till-s/kicad-usbadc-s7m19507/hw/ft240x_fpga_test.kicad_pcb

## KiCad design hw/ft240x_fpga_test.kicad_pcb (2021-11-04)

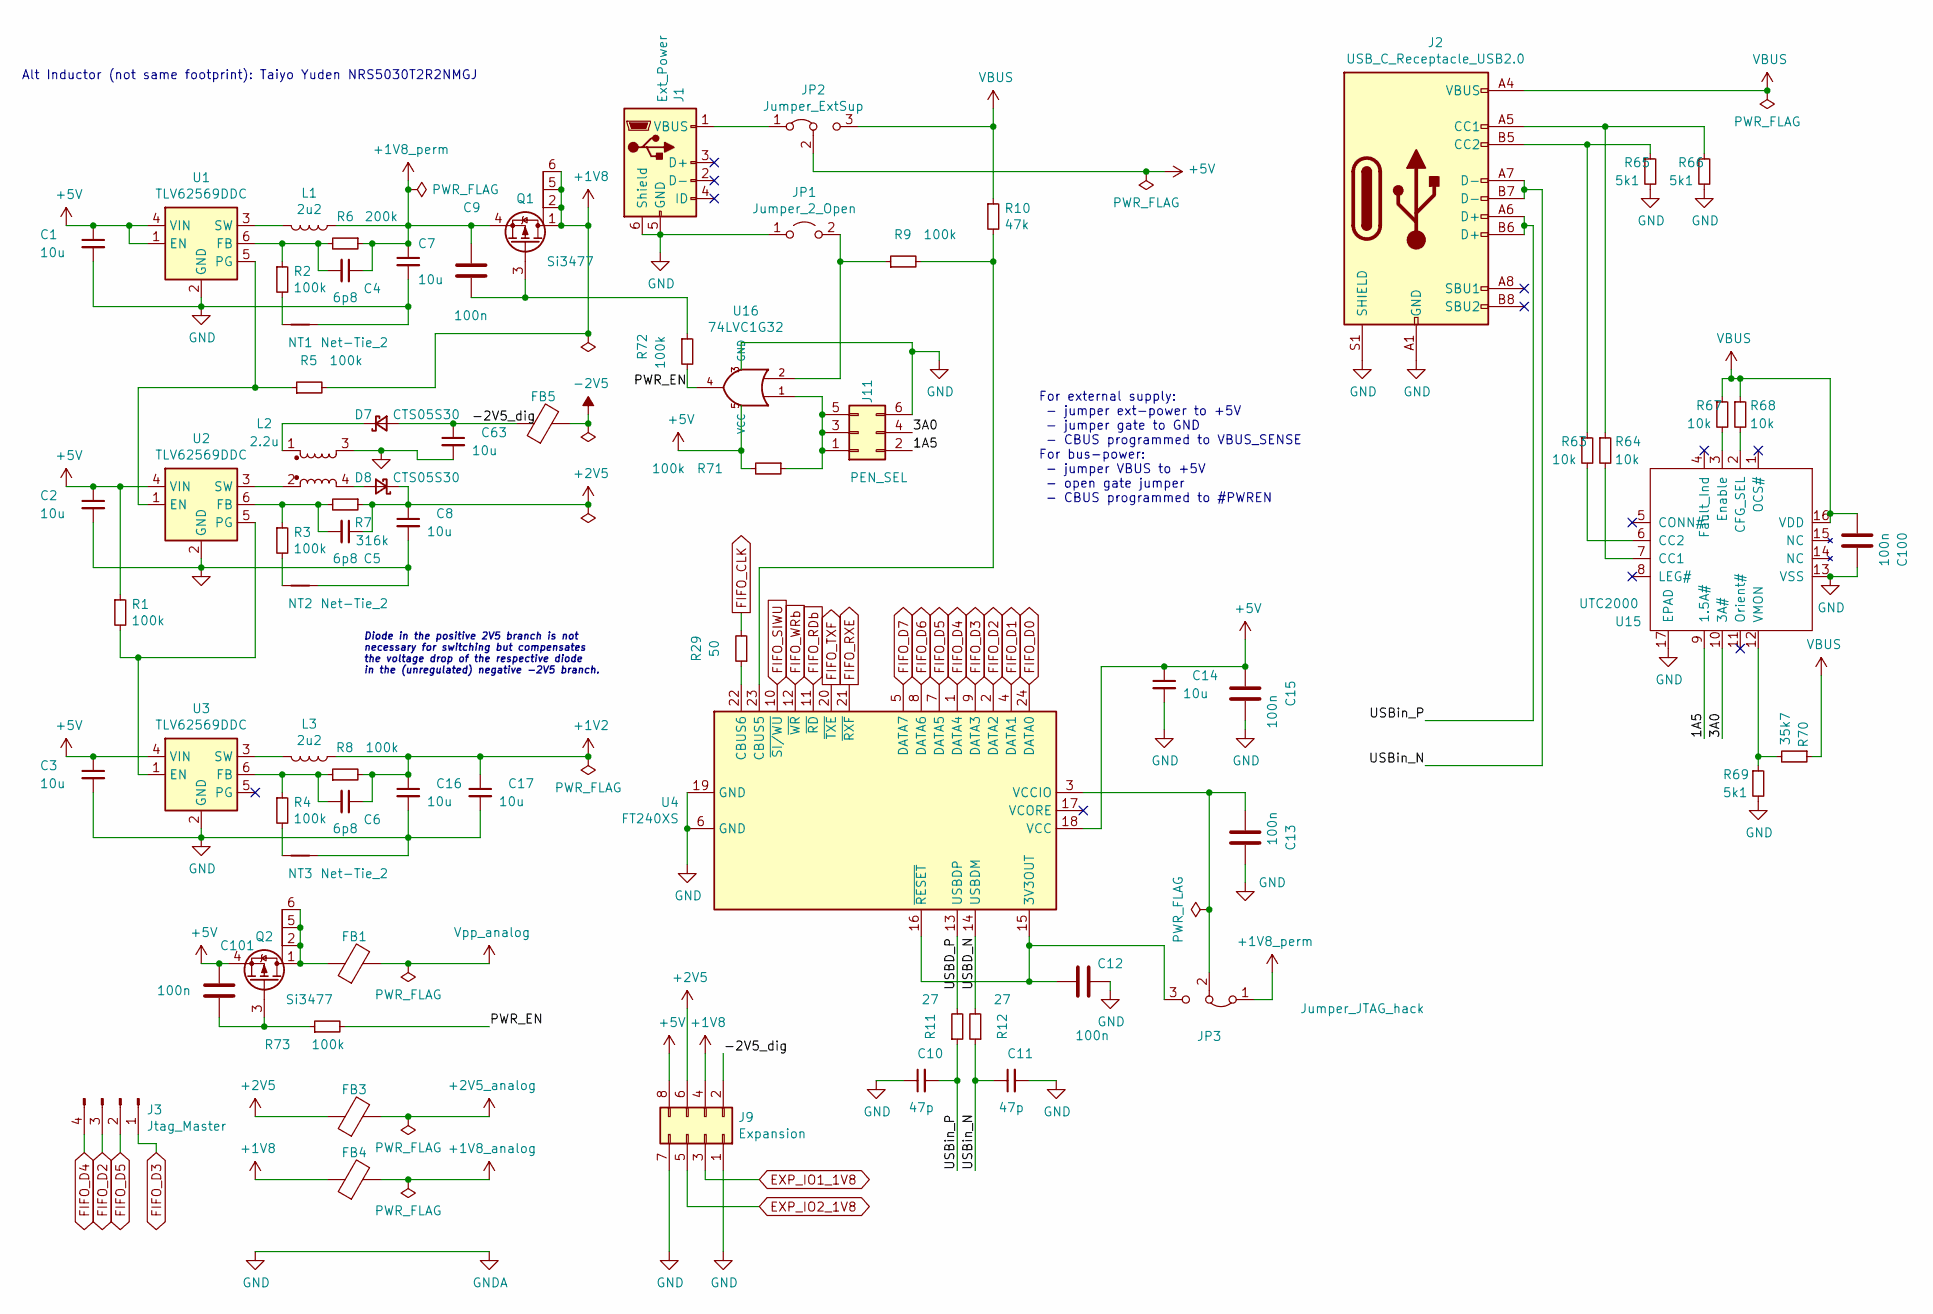
[picture p1: schematic power.sch]

Parts:
C1, C2, C3, C7, C8, C14, C16, C17, C63: 10u; C_1206_3216Metric; Part CNC5L1X7R1C106K160AE
C4, C5, C6: 6p8; C_0603_1608Metric; Part 885012006050
C9, C12, C13, C15, C100, C101: 100n; C_0603_1608Metric; Part GCJ188R71E104KA12D
C10, C11: 47p; C_0603_1608Metric; Part 885012006055
D7: CTS05S30; sod323; Part CTS05S30
D8: CTS05S30; sod323-special; Part CTS05S30
FB1, FB3, FB4, FB5: Ferrite_Bead MPZ1608S221A; L_0603_1608Metric; Part MPZ1608S221ATA00
J1: Ext_Power; USB_Micro-B_Molex-105017-0001; Part 1050170001
J2: USB_C_Receptacle_USB2.0; USB_C_Receptacle_GCT_USB4085_smaller_holes
J3: Jtag_Master; PinHeader_1x04_P2.54mm_Vertical
J9: Expansion; PinHeader_2x04_P2.54mm_Vertical
J11: PEN_SEL; PinHeader_2x03_P2.54mm_Vertical
JP1: Jumper_2_Open; PinHeader_1x02_P2.54mm_Vertical
JP2: Jumper_ExtSup; PinHeader_1x03_P2.54mm_Vertical
JP3: Jumper_JTAG_hack; PinHeader_1x03_P2.54mm_Vertical
L1, L3: 2u2; L_Taiyo-Yuden_NR-50xx; Part SRN8040TA-2R2Y
L2: 2.2u; L_Taiyo-Yuden_NR-50xx+bourns0703; Part SRF0703-2R2M
NT1, NT2, NT3: Net-Tie_2; NetTie-2_SMD_Pad0.5mm
Q1, Q2: Si3477; TSOT-23-6; Part Si3477
R1, R2, R3, R4, R5, R8, R9, R71, R72, R73: 100k; R_0603_1608Metric; Part RC0603FR-07100KL
R6: 200k; R_0603_1608Metric; Part ERJ-3EKF2003V
R7: 316k; R_0603_1608Metric; Part RC0603FR-07316KL
R10: 47k; R_0603_1608Metric; Part RC0603FR-07100KL
R11, R12: 27; R_0603_1608Metric; Part RC0603FR-0727RL
R29: 50; R_0402_1005Metric
R63, R64, R67, R68: 10k; R_0603_1608Metric
R65, R66, R69: 5k1; R_0603_1608Metric
R70: 35k7; R_0603_1608Metric
U1, U2, U3: TLV62569DDC; SOT-23-6; Part TLV62569PDDC
U4: FT240XS; SSOP-24_3.9x8.7mm_P0.635mm; Part FT240XS-U
U15: UTC2000; QFN-16-1EP_3x3mm_P0.5mm_EP1.75x1.75mm_ThermalVias; Part UTC2000
U16: 74LVC1G32; SOT-353_SC-70-5

Connections:
+1V2: C6.1, C16.1, C17.1, L3.1, R8.2; also elsewhere on the board
+1V8: FB4.1, J9.4, Q1.1 (D), Q1.2 (D), Q1.5 (D), Q1.6 (D), R5.2; also elsewhere on the board
+1V8_analog: FB4.2; also elsewhere on the board
+1V8_perm: C4.1, C7.1, C9.2, JP3.1 (A), L1.1, Q1.4 (S), R6.1
+2V5: C5.1, C8.1, D8.1 (K), FB3.1, J9.6, R7.1; also elsewhere on the board
+2V5_analog: FB3.2; also elsewhere on the board
+5V: C1.1, C2.1, C3.1, C14.1, C15.2, C101.2, J9.8, JP2.2 (C), Q2.4 (S), R1.1, R71.2, U1.1 (EN), U1.4 (VIN), U2.4 (VIN), U3.4 (VIN), U4.18 (VCC), U16.5 (VCC); also elsewhere on the board
-2V5: FB5.2; also elsewhere on the board
/Power/1A5: J11.2, U15.9 (1.5A#)
/Power/3A0: J11.4, U15.10 (3A#)
/Power/-2V5_dig: C63.1, D7.2 (A), FB5.1, J9.2
/Power/PWR_EN: R72.2, R73.2, U16.4
/Power/USBD_N: R12.2, U4.14 (USBDM)
/Power/USBD_P: R11.2, U4.13 (USBDP)
/Power/USBin_N: C11.1, J2.A7 (D-), J2.B7 (D-), R12.1
/Power/USBin_P: C10.2, J2.A6 (D+), J2.B6 (D+), R11.1
EXP_IO1_1V8: J9.3; also elsewhere on the board
EXP_IO2_1V8: J9.5; also elsewhere on the board
FIFO_CLK: R29.2; also elsewhere on the board
FIFO_D0: U4.24 (DATA0); also elsewhere on the board
FIFO_D1: U4.4 (DATA1); also elsewhere on the board
FIFO_D2: J3.3, U4.2 (DATA2); also elsewhere on the board
FIFO_D3: J3.1, U4.9 (DATA3); also elsewhere on the board
FIFO_D4: J3.4, U4.1 (DATA4); also elsewhere on the board
FIFO_D5: J3.2, U4.7 (DATA5); also elsewhere on the board
FIFO_D6: U4.8 (DATA6); also elsewhere on the board
FIFO_D7: U4.5 (DATA7); also elsewhere on the board
FIFO_RDb: U4.11 (~RD); also elsewhere on the board
FIFO_RXE: U4.21 (~RXF); also elsewhere on the board
FIFO_SIWU: U4.10 (~SI/WU); also elsewhere on the board
FIFO_TXF: U4.20 (~TXE); also elsewhere on the board
FIFO_WRb: U4.12 (~WR); also elsewhere on the board
unnamed: C4.2, R2.1, R6.2, U1.6 (FB)
unnamed: C5.2, R3.1, R7.2, U2.6 (FB)
unnamed: C6.2, R4.1, R8.1, U3.6 (FB)
unnamed: C9.1, Q1.3 (G), R72.1
unnamed: C12.2, JP3.3 (B), U4.15 (3V3OUT), U4.16 (~RESET)
unnamed: C13.2, JP3.2 (C), U4.3 (VCCIO)
unnamed: C101.1, Q2.3 (G), R73.1
unnamed: D7.1 (K), L2.1
unnamed: D8.2 (A), L2.4
unnamed: FB1.1, Q2.1 (D), Q2.2 (D), Q2.5 (D), Q2.6 (D)
unnamed: J1.1 (VBUS), JP2.1 (A)
unnamed: J2.A5 (CC1), R64.1, R66.1
unnamed: J2.B5 (CC2), R63.1, R65.1
unnamed: J11.1, J11.3, J11.5, R71.1, U16.1
unnamed: JP1.2 (B), R9.1, U16.2
unnamed: L1.2, U1.3 (SW)
unnamed: L2.2, U2.3 (SW)
unnamed: L3.2, U3.3 (SW)
unnamed: NT1.1, R2.2
unnamed: NT2.1, R3.2
unnamed: NT3.1, R4.2
unnamed: R1.2, U2.5 (PG), U3.1 (EN)
unnamed: R5.1, U1.5 (PG), U2.1 (EN)
unnamed: R9.2, R10.2, U4.23 (CBUS5)
unnamed: R29.1, U4.22 (CBUS6)
unnamed: R63.2, U15.6 (CC2)
unnamed: R64.2, U15.7 (CC1)
unnamed: R67.2, U15.3 (Enable)
unnamed: R68.2, U15.2 (CFG_SEL)
unnamed: R69.1, R70.2, U15.12 (VMON)
VBUS: C100.1, J2.A4 (VBUS), J2.A9 (VBUS), J2.B4 (VBUS), J2.B9 (VBUS), JP2.3 (B), R10.1, R67.1, R68.1, R70.1, U15.16 (VDD)
Vpp_analog: FB1.2; also elsewhere on the board

Notes on the sheet:
For external supply: - jumper ext-power to +5V - jumper gate to GND - CBUS programmed to VBUS_SENSE For bus-power: - jumper VBUS to +5V - open gate jumper - CBUS programmed to #PWREN
Alt Inductor (not same footprint): Taiyo Yuden NRS5030T2R2NMGJ
Diode in the positive 2V5 branch is not necessary for switching but compensates the voltage drop of the respective diode in the (unregulated) negative -2V5 branch.

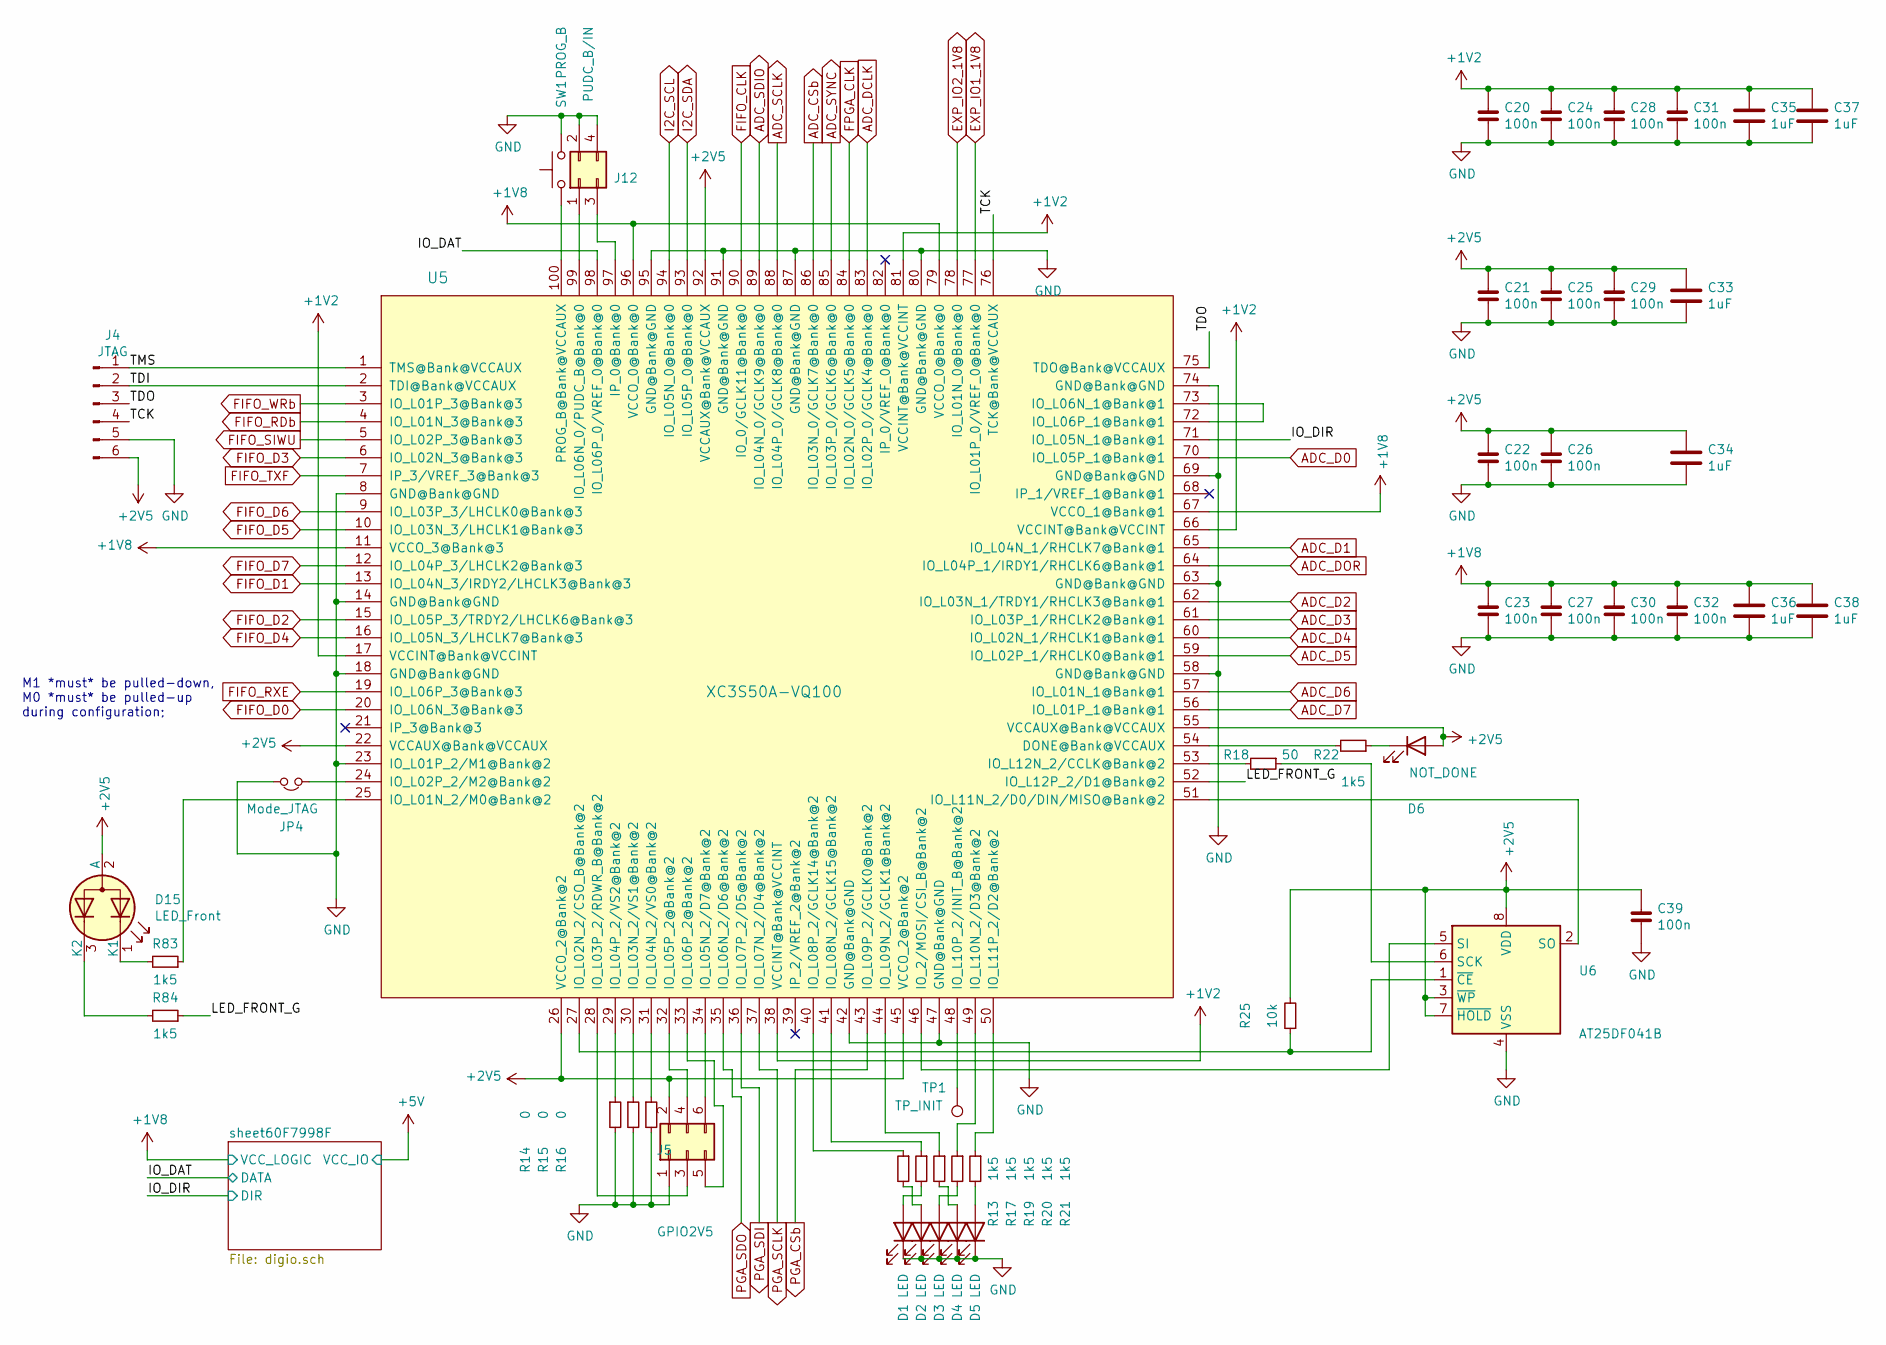
[picture p2: schematic fpga_xc3s.sch]

Parts:
C20, C21, C22, C23, C24, C25, C26, C27, C28, C29, C30, C31, C32, C39: 100n; C_0402_1005Metric; Part GRM155R61C104KA88D
C33, C34, C35, C36, C37, C38: 1uF; C_0805_2012Metric; Part GCJ219R71C105KA01
D1, D2, D3, D4, D5, D6: LED; LED_0603_1608Metric; Part 150060RS75000
D15: LED_Front; LED_Wuerth_Sideview
J4: JTAG; PinHeader_1x06_P2.54mm_Vertical
J5: GPIO2V5; PinHeader_2x03_P2.54mm_Vertical
J12: PUDC_B/IN; PinHeader_2x02_P2.54mm_Vertical
JP4: Mode_JTAG; PinHeader_1x02_P2.54mm_Vertical
R13, R17, R19, R20, R21, R22, R83, R84: 1k5; R_0603_1608Metric; Part RC0603FR-071K5L
R14, R15, R16: 0; R_0603_1608Metric; Part RMCF0603ZT0R00
R18: 50; R_0603_1608Metric
R25: 10k; R_0603_1608Metric; Part RT0603FRE0710KL
SW1: PROG_B; SW_SPST_PTS810
TP1: TP_INIT; TestPoint_Pad_D1.0mm
U5: XC3S50A-VQ100; VQFP-100_14x14mm_P0.5mm
U6: AT25DF041B; SOIC-8_3.9x4.9mm_P1.27mm; Part AT25DF041B

Connections:
+1V2: C20.1, C24.1, C28.1, C31.1, C35.1, C37.1, U5.17 (VCCINT@Bank@VCCINT), U5.38 (VCCINT@Bank@VCCINT), U5.66 (VCCINT@Bank@VCCINT), U5.81 (VCCINT@Bank@VCCINT); also elsewhere on the board
+1V8: C23.1, C27.1, C30.1, C32.1, C36.1, C38.1, U5.11 (VCCO_3@Bank@3), U5.67 (VCCO_1@Bank@1), U5.79 (VCCO_0@Bank@0), U5.96 (VCCO_0@Bank@0); also elsewhere on the board
+2V5: C21.1, C22.1, C25.1, C26.1, C29.1, C33.1, C34.1, C39.1, D6.2 (A), D15.2 (A), J4.6, J5.2, R25.2, U5.22 (VCCAUX@Bank@VCCAUX), U5.26 (VCCO_2@Bank@2), U5.45 (VCCO_2@Bank@2), U5.55 (VCCAUX@Bank@VCCAUX), U5.92 (VCCAUX@Bank@VCCAUX), U6.3 (~WP~), U6.7 (~HOLD~), U6.8 (VDD); also elsewhere on the board
/fpga_xc3s/IO_DAT: U5.98 (IO_L06P_0/VREF_0@Bank@0); also elsewhere on the board
/fpga_xc3s/IO_DIR: U5.71 (IO_L05N_1@Bank@1); also elsewhere on the board
/fpga_xc3s/LED_FRONT_G: R84.1, U5.52 (IO_L12P_2/D1@Bank@2)
/fpga_xc3s/TCK: J4.4, U5.76 (TCK@Bank@VCCAUX)
/fpga_xc3s/TDI: J4.2, U5.2 (TDI@Bank@VCCAUX)
/fpga_xc3s/TDO: J4.3, U5.75 (TDO@Bank@VCCAUX)
/fpga_xc3s/TMS: J4.1, U5.1 (TMS@Bank@VCCAUX)
ADC_CSb: U5.86 (IO_L03N_0/GCLK7@Bank@0); also elsewhere on the board
ADC_D0: U5.70 (IO_L05P_1@Bank@1); also elsewhere on the board
ADC_D1: U5.65 (IO_L04N_1/RHCLK7@Bank@1); also elsewhere on the board
ADC_D2: U5.62 (IO_L03N_1/TRDY1/RHCLK3@Bank@1); also elsewhere on the board
ADC_D3: U5.61 (IO_L03P_1/RHCLK2@Bank@1); also elsewhere on the board
ADC_D4: U5.60 (IO_L02N_1/RHCLK1@Bank@1); also elsewhere on the board
ADC_D5: U5.59 (IO_L02P_1/RHCLK0@Bank@1); also elsewhere on the board
ADC_D6: U5.57 (IO_L01N_1@Bank@1); also elsewhere on the board
ADC_D7: U5.56 (IO_L01P_1@Bank@1); also elsewhere on the board
ADC_DCLK: U5.83 (IO_L02P_0/GCLK4@Bank@0); also elsewhere on the board
ADC_DOR: U5.64 (IO_L04P_1/IRDY1/RHCLK6@Bank@1); also elsewhere on the board
ADC_SCLK: U5.88 (IO_L04P_0/GCLK8@Bank@0); also elsewhere on the board
ADC_SDIO: U5.89 (IO_L04N_0/GCLK9@Bank@0); also elsewhere on the board
ADC_SYNC: U5.85 (IO_L03P_0/GCLK6@Bank@0); also elsewhere on the board
EXP_IO1_1V8: U5.77 (IO_L01P_0/VREF_0@Bank@0); also elsewhere on the board
EXP_IO2_1V8: U5.78 (IO_L01N_0@Bank@0); also elsewhere on the board
FIFO_CLK: U5.90 (IO_0/GCLK11@Bank@0); also elsewhere on the board
FIFO_D0: U5.20 (IO_L06N_3@Bank@3); also elsewhere on the board
FIFO_D1: U5.13 (IO_L04N_3/IRDY2/LHCLK3@Bank@3); also elsewhere on the board
FIFO_D2: U5.15 (IO_L05P_3/TRDY2/LHCLK6@Bank@3); also elsewhere on the board
FIFO_D3: U5.6 (IO_L02N_3@Bank@3); also elsewhere on the board
FIFO_D4: U5.16 (IO_L05N_3/LHCLK7@Bank@3); also elsewhere on the board
FIFO_D5: U5.10 (IO_L03N_3/LHCLK1@Bank@3); also elsewhere on the board
FIFO_D6: U5.9 (IO_L03P_3/LHCLK0@Bank@3); also elsewhere on the board
FIFO_D7: U5.12 (IO_L04P_3/LHCLK2@Bank@3); also elsewhere on the board
FIFO_RDb: U5.4 (IO_L01N_3@Bank@3); also elsewhere on the board
FIFO_RXE: U5.19 (IO_L06P_3@Bank@3); also elsewhere on the board
FIFO_SIWU: U5.5 (IO_L02P_3@Bank@3); also elsewhere on the board
FIFO_TXF: U5.7 (IP_3/VREF_3@Bank@3); also elsewhere on the board
FIFO_WRb: U5.3 (IO_L01P_3@Bank@3); also elsewhere on the board
FPGA_CLK: U5.84 (IO_L02N_0/GCLK5@Bank@0); also elsewhere on the board
I2C_SCL: U5.94 (IO_L05N_0@Bank@0); also elsewhere on the board
I2C_SDA: U5.93 (IO_L05P_0@Bank@0); also elsewhere on the board
unnamed: D1.2 (A), R17.2
unnamed: D2.2 (A), R13.2
unnamed: D3.2 (A), R20.2
unnamed: D4.2 (A), R19.2
unnamed: D5.2 (A), R21.2
unnamed: D6.1 (K), R22.1
unnamed: D15.1 (K1), R83.2
unnamed: D15.3 (K2), R84.2
unnamed: J5.3, U5.28 (IO_L03P_2/RDWR_B@Bank@2)
unnamed: J5.4, U5.32 (IO_L05P_2@Bank@2)
unnamed: J5.5, U5.33 (IO_L06P_2@Bank@2)
unnamed: J5.6, U5.34 (IO_L05N_2/D7@Bank@2)
unnamed: J12.1, U5.99 (IO_L06N_0/PUDC_B@Bank@0)
unnamed: J12.3, U5.97 (IP_0@Bank@0)
unnamed: JP4.1, U5.24 (IO_L02P_2/M2@Bank@2)
unnamed: R13.1, U5.40 (IO_L08P_2/GCLK14@Bank@2)
unnamed: R14.1, U5.29 (IO_L04P_2/VS2@Bank@2)
unnamed: R15.1, U5.30 (IO_L03N_2/VS1@Bank@2)
unnamed: R16.1, U5.31 (IO_L04N_2/VS0@Bank@2)
unnamed: R17.1, U5.41 (IO_L08N_2/GCLK15@Bank@2)
unnamed: R18.1, U6.6 (SCK)
unnamed: R18.2, U5.53 (IO_L12N_2/CCLK@Bank@2)
unnamed: R19.1, U5.44 (IO_L09N_2/GCLK1@Bank@2)
unnamed: R20.1, U5.49 (IO_L10N_2/D3@Bank@2)
unnamed: R21.1, U5.50 (IO_L11P_2/D2@Bank@2)
unnamed: R22.2, U5.54 (DONE@Bank@VCCAUX)
unnamed: R25.1, U5.27 (IO_L02N_2/CSO_B@Bank@2), U6.1 (~CE)
unnamed: R83.1, U5.25 (IO_L01N_2/M0@Bank@2)
unnamed: SW1.1, U5.100 (PROG_B@Bank@VCCAUX)
unnamed: TP1.1, U5.48 (IO_L10P_2/INIT_B@Bank@2)
unnamed: U5.46 (IO_2/MOSI/CSI_B@Bank@2), U6.5 (SI)
unnamed: U5.51 (IO_L11N_2/D0/DIN/MISO@Bank@2), U6.2 (SO)
unnamed: U5.72 (IO_L06P_1@Bank@1), U5.73 (IO_L06N_1@Bank@1)
PGA_CSb: U5.43 (IO_L09P_2/GCLK0@Bank@2); also elsewhere on the board
PGA_SCLK: U5.37 (IO_L07N_2/D4@Bank@2); also elsewhere on the board
PGA_SDI: U5.36 (IO_L07P_2/D5@Bank@2); also elsewhere on the board
PGA_SDO: U5.35 (IO_L06N_2/D6@Bank@2); also elsewhere on the board

Notes on the sheet:
M1 *must* be pulled-down, M0 *must* be pulled-up during configuration;

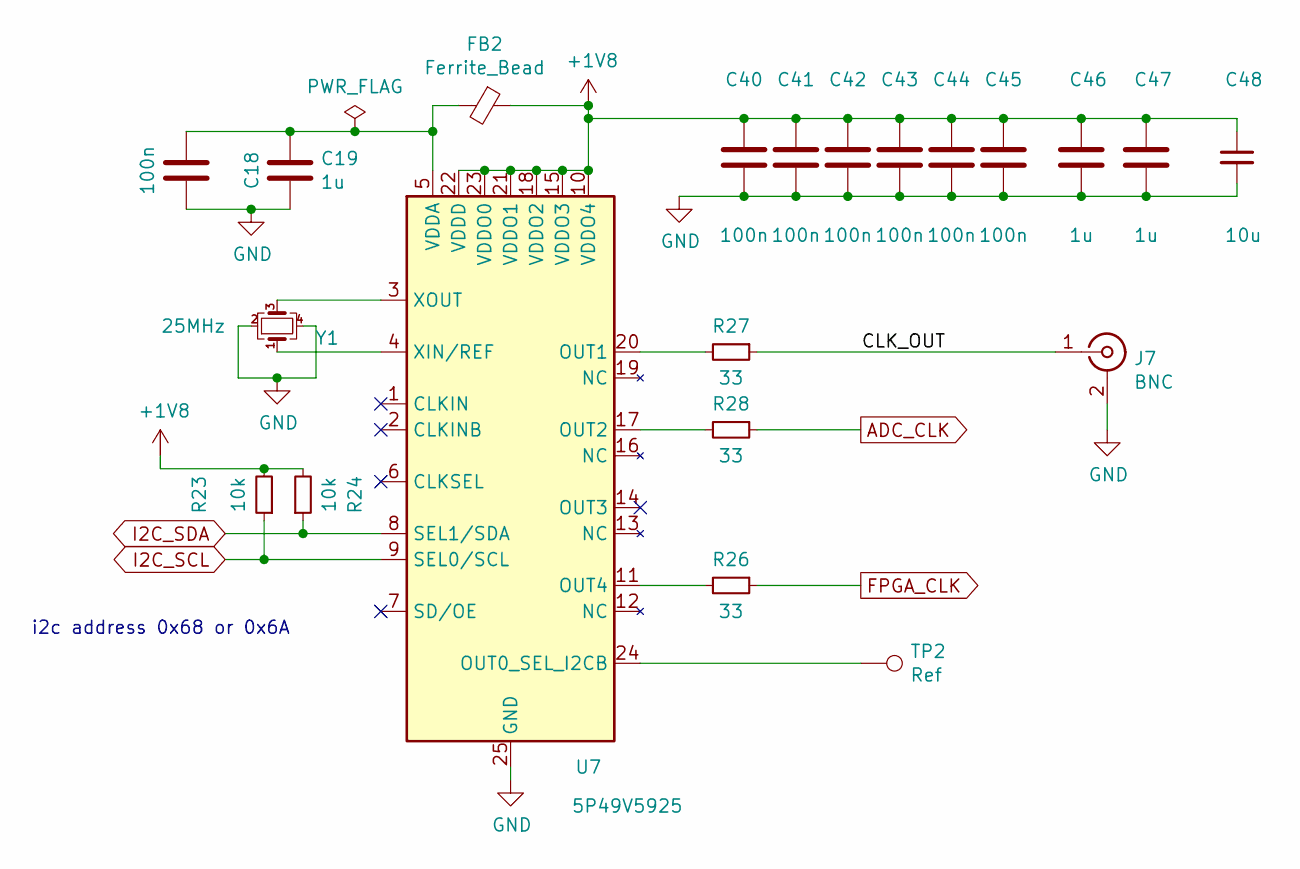
[picture p3: schematic pll_clock.sch]

Parts:
C18, C40, C41, C42, C43, C44, C45: 100n; C_0603_1608Metric; Part GCJ188R71E104KA12D
C19, C46, C47: 1u; C_0805_2012Metric; Part GCJ219R71C105KA01
C48: 10u; C_1206_3216Metric; Part CNC5L1X7R1C106K160AE
FB2: Ferrite_Bead; L_0603_1608Metric; Part MPZ1608S221ATA00
J7: BNC; BNC_Molex_0731713150; Part 0731713150
R23, R24: 10k; R_0603_1608Metric; Part RT0603FRE0710KL
R26, R27, R28: 33; R_0603_1608Metric; Part RC0603FR-0733RL
TP2: Ref; TestPoint_Pad_D0.8mm_no_CY
U7: 5P49V5925; QFN-24-1EP_4x4mm_P0.5mm_EP2.8x2.8mm; Part 5P49V5925
Y1: 25MHz; Crystal_SMD_Abracon_ABM10-4Pin_2.5x2.0mm; Part ABM10W-25.0000MHZ-8-B1U-T3

Connections:
+1V8: C40.2, C41.2, C42.2, C43.2, C44.2, C45.2, C46.1, C47.1, C48.1, FB2.1, R23.2, R24.2, U7.10 (VDDO4), U7.15 (VDDO3), U7.18 (VDDO2), U7.21 (VDDO1), U7.22 (VDDD), U7.23 (VDDO0); also elsewhere on the board
/pll_clock/CLK_OUT: J7.1 (In), R27.1
ADC_CLK: R28.1; also elsewhere on the board
FPGA_CLK: R26.1; also elsewhere on the board
I2C_SCL: R23.1, U7.9 (SEL0/SCL); also elsewhere on the board
I2C_SDA: R24.1, U7.8 (SEL1/SDA); also elsewhere on the board
unnamed: C18.2, C19.1, FB2.2, U7.5 (VDDA)
unnamed: R26.2, U7.11 (OUT4)
unnamed: R27.2, U7.20 (OUT1)
unnamed: R28.2, U7.17 (OUT2)
unnamed: TP2.1, U7.24 (OUT0_SEL_I2CB)
unnamed: U7.3 (XOUT), Y1.3
unnamed: U7.4 (XIN/REF), Y1.1

Notes on the sheet:
i2c address 0x68 or 0x6A

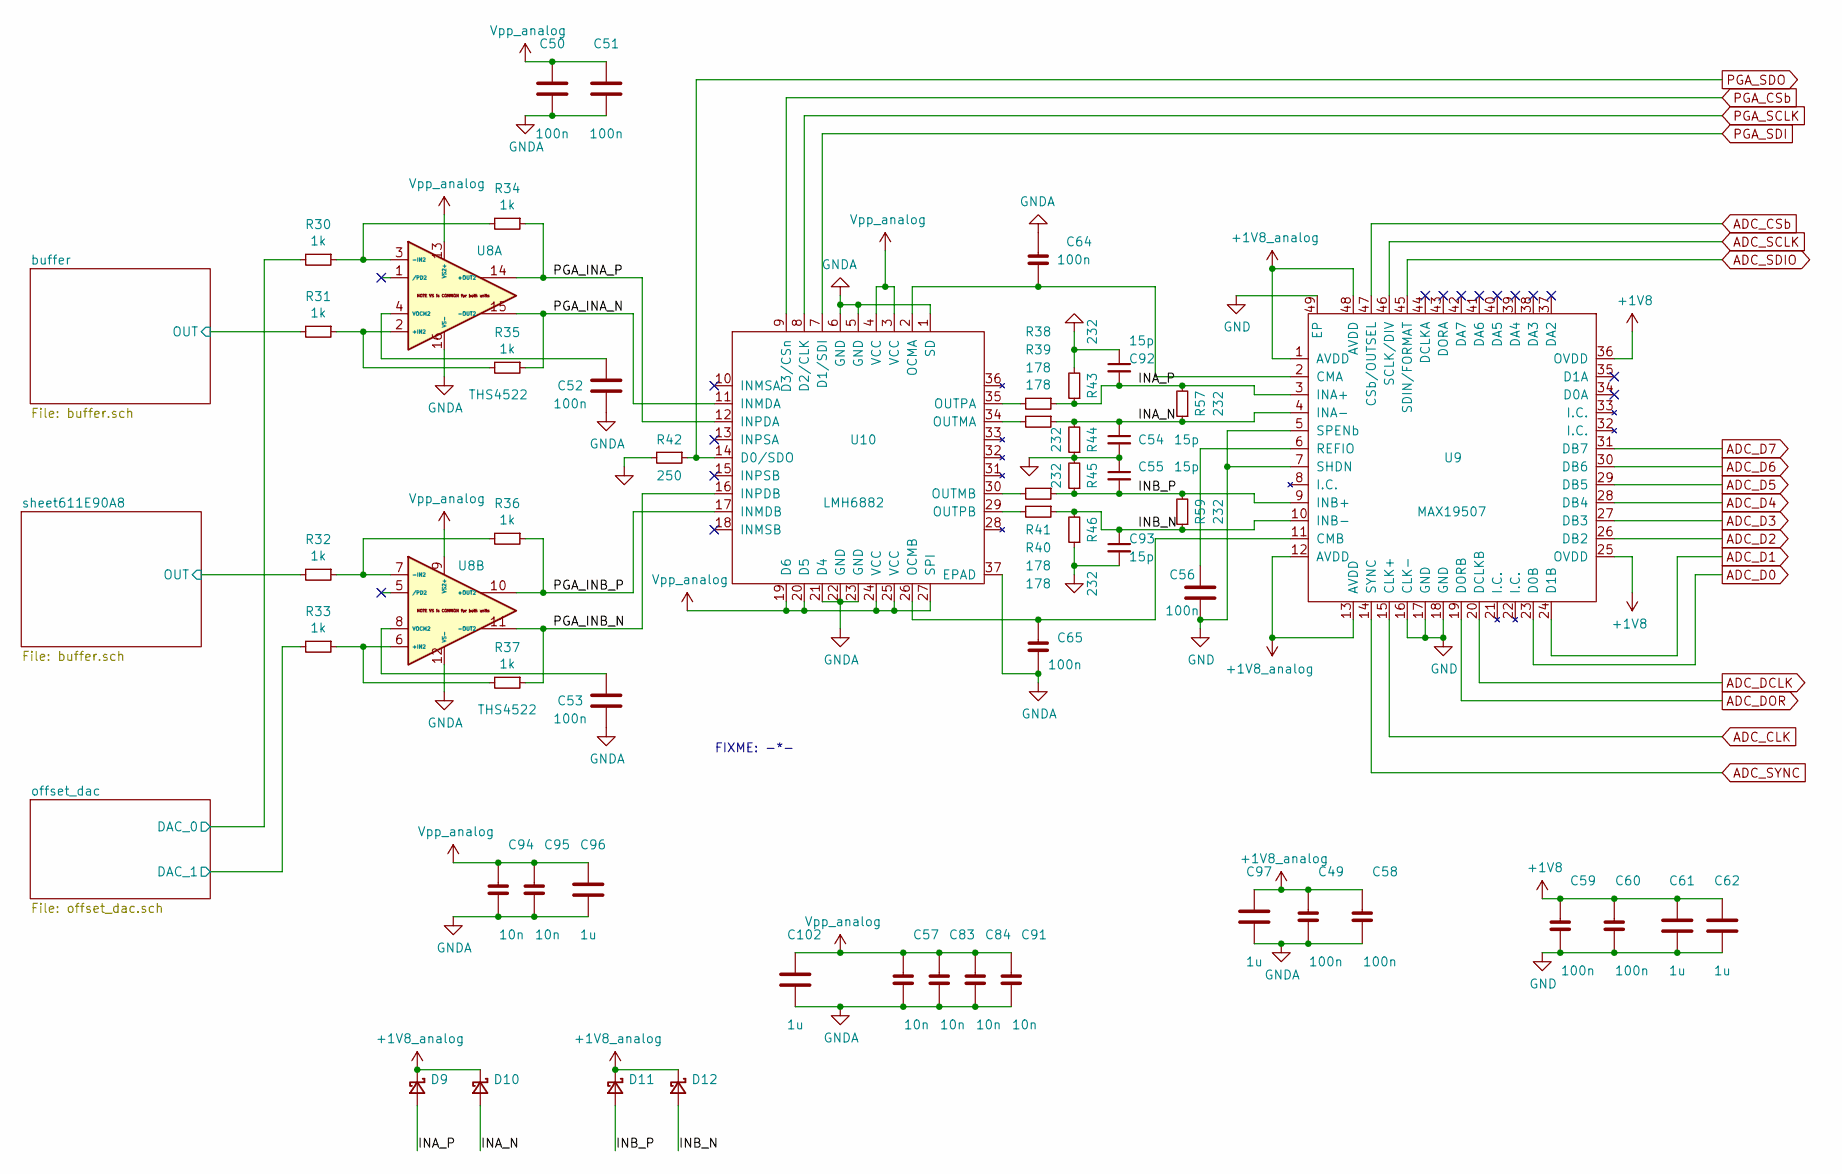
[picture p4: schematic max19507.sch]

Parts:
C49, C58, C59, C60, C64, C65: 100n; C_0402_1005Metric; Part GRM155R61C104KA88D
C50, C51, C52, C53, C56: 100n; C_0603_1608Metric; Part GCJ188R71E104KA12D
C54, C55, C92, C93: 15p; C_0603_1608Metric
C57, C83, C84, C91, C94, C95: 10n; C_0402_1005Metric; Part GRM155R61C103KA01
C61, C62, C96, C97, C102: 1u; C_0805_2012Metric; Part GCJ219R71C105KA01
D9, D10, D11, D12: NSR0170HT1G; D_SOD-323; Part NSR0170HT1G
R30, R31, R32, R33, R34, R35, R36, R37: 1k; R_0603_1608Metric
R38, R39, R40, R41: 178; R_0603_1608Metric
R42: 250; R_0603_1608Metric
R43, R44, R45, R46, R57, R59: 232; R_0603_1608Metric
U8: THS4522; TSSOP-16_4.4x5mm_P0.65mm
U9: MAX19507; TQFP-48-1EP_7x7mm_P0.5mm_EP5x5mm_ThermalVias
U10: LMH6882; Texas_S-PVQFN-N36_EP4.4x4.4mm_ThermalVias; Part LMH6882

Connections:
+1V8: C59.1, C60.1, C61.1, C62.1, U9.25 (OVDD), U9.36 (OVDD); also elsewhere on the board
+1V8_analog: C49.1, C58.1, C97.1, D9.1 (K), D10.1 (K), D11.1 (K), D12.1 (K), U9.1 (AVDD), U9.12 (AVDD), U9.13 (AVDD), U9.48 (AVDD); also elsewhere on the board
/ADC+Driver/INA_N: C54.1, D10.2 (A), R39.1, R44.2, R57.1, U9.4 (INA-)
/ADC+Driver/INA_P: C92.2, D9.2 (A), R38.1, R43.1, R57.2, U9.3 (INA+)
/ADC+Driver/INB_N: C93.1, D12.2 (A), R41.1, R46.2, R59.1, U9.10 (INB-)
/ADC+Driver/INB_P: C55.2, D11.2 (A), R40.1, R45.1, R59.2, U9.9 (INB+)
/ADC+Driver/PGA_INA_N: R35.1, U8.15 (-OUT2), U10.11 (INMDA)
/ADC+Driver/PGA_INA_P: R34.1, U8.14 (+OUT2), U10.12 (INPDA)
/ADC+Driver/PGA_INB_N: R37.1, U8.11 (-OUT2), U10.16 (INPDB)
/ADC+Driver/PGA_INB_P: R36.1, U8.10 (+OUT2), U10.17 (INMDB)
/ADC+Driver/buffer/OUT: R31.2; also elsewhere on the board
/ADC+Driver/offset_dac/DAC_0: R30.2; also elsewhere on the board
/ADC+Driver/offset_dac/DAC_1: R33.2; also elsewhere on the board
/ADC+Driver/sheet611E90A8/OUT: R32.2; also elsewhere on the board
ADC_CLK: U9.15 (CLK+); also elsewhere on the board
ADC_CSb: U9.47 (CSb/OUTSEL); also elsewhere on the board
ADC_D0: U9.23 (D0B); also elsewhere on the board
ADC_D1: U9.24 (D1B); also elsewhere on the board
ADC_D2: U9.26 (DB2); also elsewhere on the board
ADC_D3: U9.27 (DB3); also elsewhere on the board
ADC_D4: U9.28 (DB4); also elsewhere on the board
ADC_D5: U9.29 (DB5); also elsewhere on the board
ADC_D6: U9.30 (DB6); also elsewhere on the board
ADC_D7: U9.31 (DB7); also elsewhere on the board
ADC_DCLK: U9.20 (DCLKB); also elsewhere on the board
ADC_DOR: U9.19 (DORB); also elsewhere on the board
ADC_SCLK: U9.46 (SCLK/DIV); also elsewhere on the board
ADC_SDIO: U9.45 (SDIN/FORMAT); also elsewhere on the board
ADC_SYNC: U9.14 (SYNC); also elsewhere on the board
unnamed: C52.2, U8.4 (VOCM2)
unnamed: C53.2, U8.8 (VOCM2)
unnamed: C56.2, U9.6 (REFIO)
unnamed: C64.2, U9.2 (CMA), U10.2 (OCMA)
unnamed: C65.1, U9.11 (CMB), U10.26 (OCMB)
unnamed: R30.1, R34.2, U8.3 (-IN2)
unnamed: R31.1, R35.2, U8.2 (+IN2)
unnamed: R32.1, R36.2, U8.7 (-IN2)
unnamed: R33.1, R37.2, U8.6 (+IN2)
unnamed: R38.2, U10.35 (OUTPA)
unnamed: R39.2, U10.34 (OUTMA)
unnamed: R40.2, U10.30 (OUTMB)
unnamed: R41.2, U10.29 (OUTPB)
PGA_CSb: U10.9 (D3/CSn); also elsewhere on the board
PGA_SCLK: U10.8 (D2/CLK); also elsewhere on the board
PGA_SDI: U10.7 (D1/SDI); also elsewhere on the board
PGA_SDO: R42.1, U10.14 (D0/SDO); also elsewhere on the board
Vpp_analog: C50.2, C51.2, C57.1, C83.1, C84.1, C91.1, C94.1, C95.1, C96.1, C102.1, U8.9 (VS2+), U8.13 (VS2+), U10.3 (VCC), U10.4 (VCC), U10.19 (D6), U10.20 (D5), U10.24 (VCC), U10.25 (VCC), U10.27 (SPI); also elsewhere on the board

Notes on the sheet:
FIXME: -*-

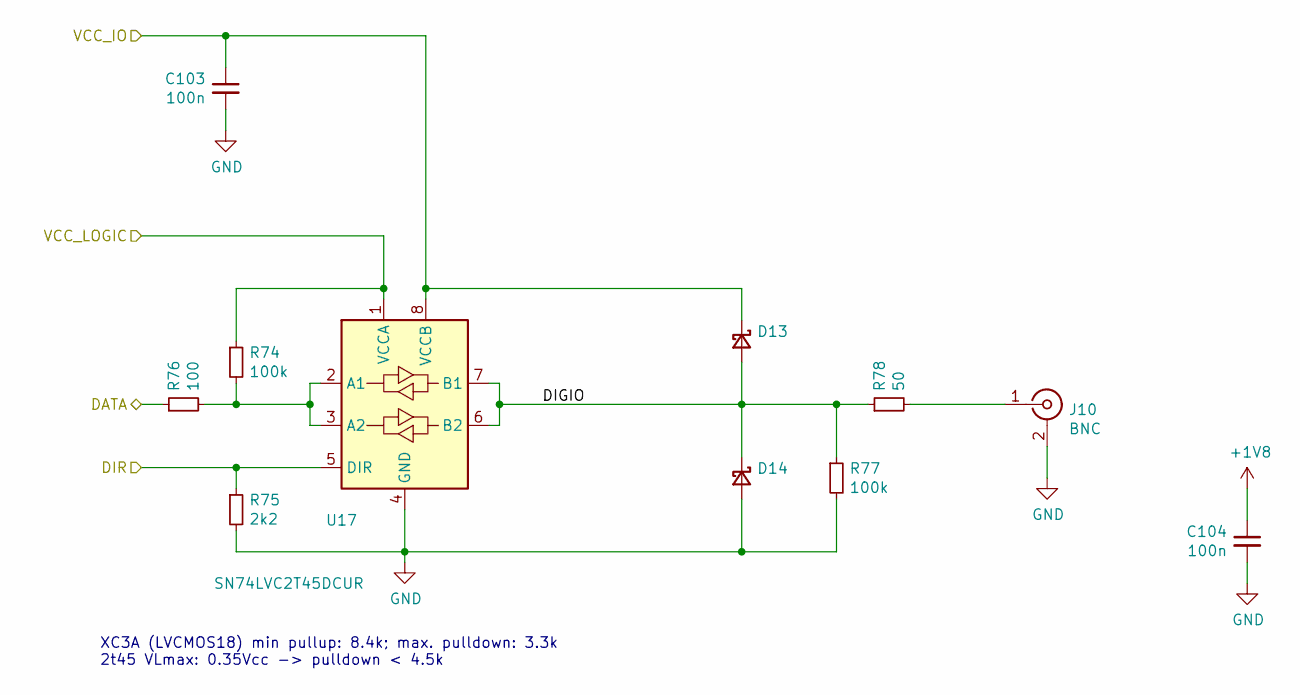
[picture p5: schematic digio.sch]

Parts:
C2001, C2002: 100n; C_0402_1005Metric
D13, D14: NSR0170HT1G; D_SOD-323; Part NSR0170HT1G
J2001: BNC; BNC_Molex_0731713150; Part 0731713150
R2001, R2005: 100k; R_0603_1608Metric
R2002: 2k2; R_0603_1608Metric
R2003: 100; R_0603_1608Metric
R2004: 50; R_0603_1608Metric
U17: SN74LVC2T45DCUR; VSSOP-8_2.4x2.1mm_P0.5mm

Connections:
+1V8: U17.1 (VCCA); also elsewhere on the board
+5V: D13.1 (K), U17.8 (VCCB); also elsewhere on the board
/fpga_xc3s/IO_DIR: U17.5 (DIR); also elsewhere on the board
/fpga_xc3s/sheet60F7998F/DIGIO: D13.2 (A), D14.1 (K), U17.6 (B2), U17.7 (B1); also elsewhere on the board
unnamed 163: U17.2 (A1), U17.3 (A2); also elsewhere on the board

Parts of its further copies:
C103, C104, C2051, C2052: 100n; C_0402_1005Metric
J10, J2051: BNC; BNC_Molex_0731713150; Part 0731713150
R74, R77, R2051, R2055: 100k; R_0603_1608Metric
R75, R2052: 2k2; R_0603_1608Metric
R76, R2053: 100; R_0603_1608Metric
R2054: 50; R_0603_1608Metric

Connections of its further copies:
+1V8: C104.1, R74.1; also elsewhere on the board
+5V: C103.1; also elsewhere on the board
/fpga_xc3s/IO_DAT: R76.1; also elsewhere on the board
/fpga_xc3s/IO_DIR: R75.1; also elsewhere on the board
/fpga_xc3s/sheet60F7998F/DIGIO: R77.1; also elsewhere on the board
unnamed 163: R74.2, R76.2; also elsewhere on the board

Notes on the sheet:
XC3A (LVCMOS18) min pullup: 8.4k; max. pulldown: 3.3k 2t45 VLmax: 0.35Vcc -> pulldown < 4.5k

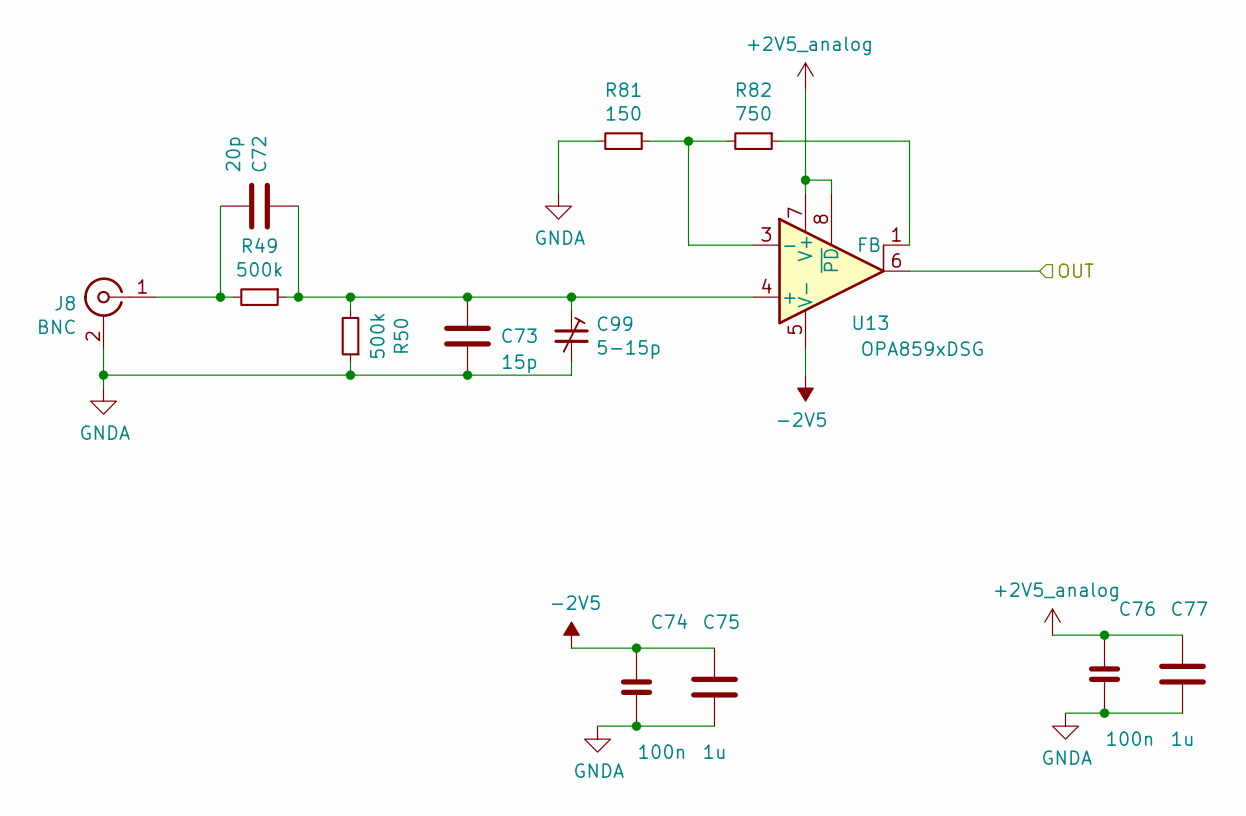
[picture p6: schematic buffer.sch]

Parts:
C66: 20p; C_0603_1608Metric
C67: 15p; C_0603_1608Metric
C68, C70: 100n; C_0402_1005Metric; Part GRM155R61C104KA88D
C69, C71: 1u; C_0805_2012Metric; Part GCJ219R71C105KA01
C98: 5-15p; C_Trimmer_EW_Electronics_SCG3S
J6: BNC; BNC_Molex_0731713150; Part 0731713150
R47, R48: 500k; R_0603_1608Metric
R81: 150; R_0402_1005Metric
R82: 750; R_0402_1005Metric
U12: OPA859xDSG; WSON-8-1EP_2x2mm_P0.5mm_EP0.9x1.6mm

Connections:
+2V5_analog: C70.1, C71.1, U12.7 (V+), U12.8 (~PD); also elsewhere on the board
-2V5: C68.1, C69.1, U12.5 (V-), U12.9 (V-); also elsewhere on the board
/ADC+Driver/buffer/OUT: U12.6; also elsewhere on the board
unnamed: C66.1, J6.1 (In), R47.2
unnamed: C66.2, C67.2, C98.1, R47.1, R48.2, U12.4 (+)

Parts of its further copies:
C72: 20p; C_0603_1608Metric
C73: 15p; C_0603_1608Metric
C74, C76: 100n; C_0402_1005Metric; Part GRM155R61C104KA88D
C75, C77: 1u; C_0805_2012Metric; Part GCJ219R71C105KA01
C99: 5-15p; C_Trimmer_EW_Electronics_SCG3S
J8: BNC; BNC_Molex_0731713150; Part 0731713150
R49, R50: 500k; R_0603_1608Metric
R79: 150; R_0402_1005Metric
R80: 750; R_0402_1005Metric
U13: OPA859xDSG; WSON-8-1EP_2x2mm_P0.5mm_EP0.9x1.6mm

Connections of its further copies:
+2V5_analog: C76.1, C77.1, U13.7 (V+), U13.8 (~PD); also elsewhere on the board
-2V5: C74.1, C75.1, U13.5 (V-), U13.9 (V-); also elsewhere on the board
/ADC+Driver/sheet611E90A8/OUT: U13.6; also elsewhere on the board
unnamed: C72.1, J8.1 (In), R49.2
unnamed: C72.2, C73.2, C99.1, R49.1, R50.2, U13.4 (+)
