till-s/kicad-usbadc-s7m19507/hw/ft240x_fpga_test.kicad_pcb

## KiCad design hw/ft240x_fpga_test.kicad_pcb (continued)

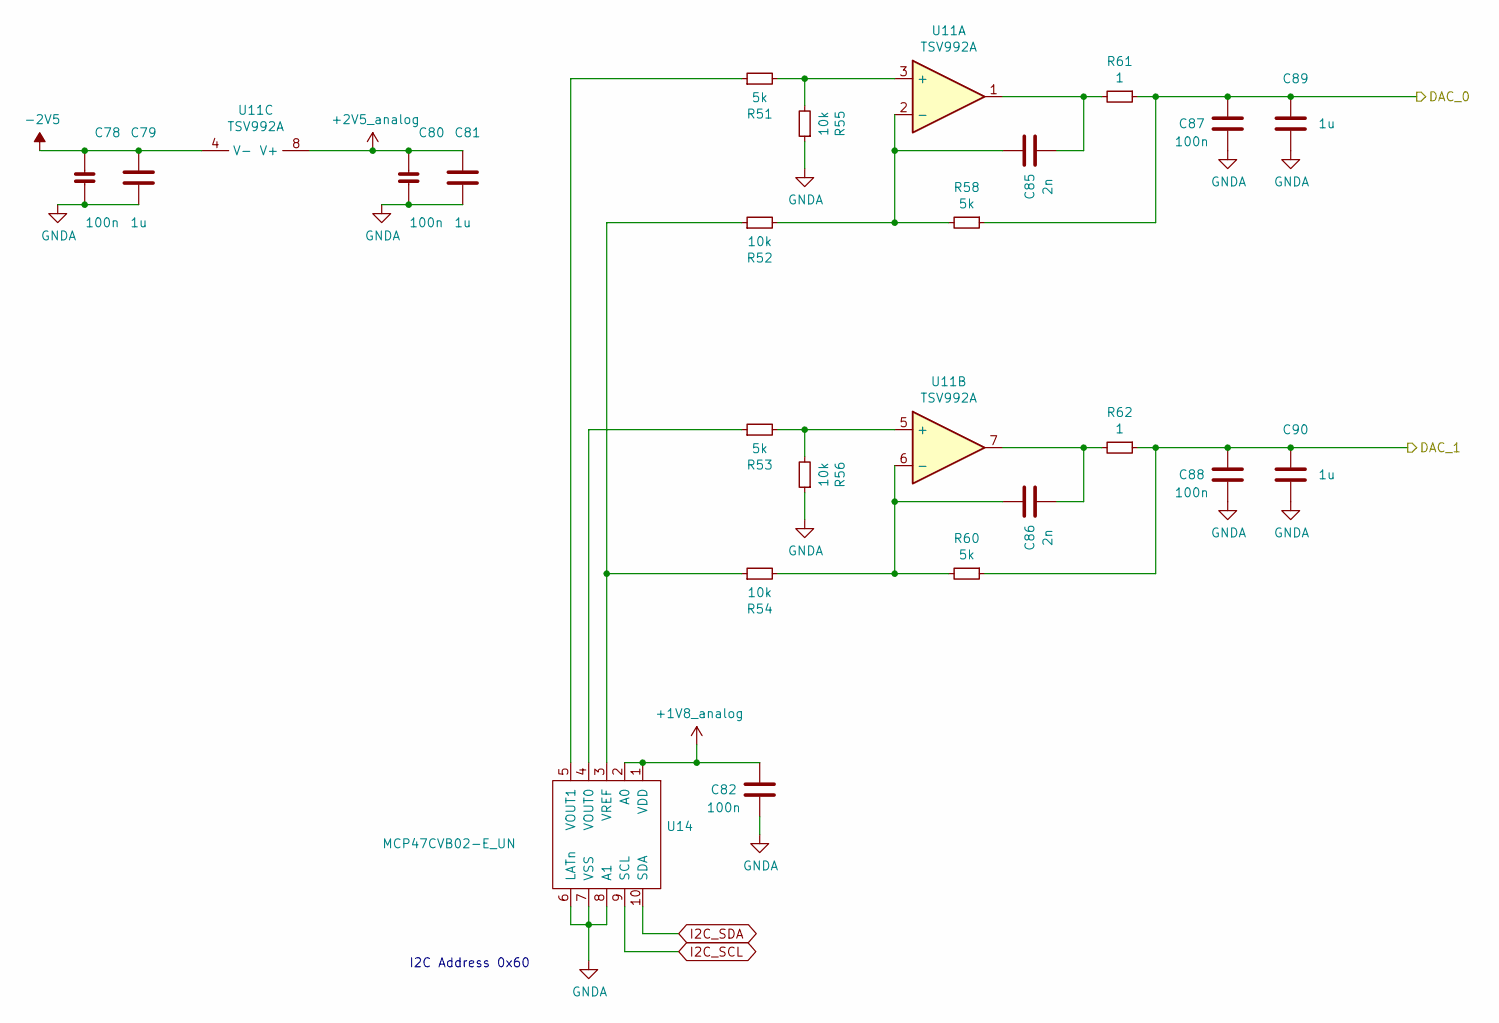
[picture p7: schematic offset_dac.sch]

Parts:
C78, C80: 100n; C_0402_1005Metric; Part GRM155R61C104KA88D
C79, C81, C89, C90: 1u; C_0805_2012Metric; Part GCJ219R71C105KA01
C82, C87, C88: 100n; C_0603_1608Metric; Part GCJ188R71E104KA12D
C85, C86: 2n; C_0603_1608Metric
R51, R53, R58, R60: 5k; R_0603_1608Metric
R52, R54, R55, R56: 10k; R_0603_1608Metric
R61, R62: 1; R_0603_1608Metric
U11: TSV992A; DFN-8-1EP_2x2mm_P0.5mm_EP0.45x1.6mm
U14: MCP47CVB02-E_UN; MSOP-10_3x3mm_P0.5mm; Part MCP47CVB02-E_UN

Connections:
+1V8_analog: C82.2, U14.1 (VDD), U14.2 (A0); also elsewhere on the board
+2V5_analog: C80.1, C81.1, U11.8 (V+); also elsewhere on the board
-2V5: C78.1, C79.1, U11.4 (V-); also elsewhere on the board
/ADC+Driver/offset_dac/DAC_0: C87.2, C89.1, R58.1, R61.1; also elsewhere on the board
/ADC+Driver/offset_dac/DAC_1: C88.2, C90.1, R60.1, R62.1; also elsewhere on the board
I2C_SCL: U14.9 (SCL); also elsewhere on the board
I2C_SDA: U14.10 (SDA); also elsewhere on the board
unnamed: C85.1, R61.2, U11.1
unnamed: C85.2, R52.2, R58.2, U11.2 (-)
unnamed: C86.1, R62.2, U11.7
unnamed: C86.2, R54.2, R60.2, U11.6 (-)
unnamed: R51.1, U14.5 (VOUT1)
unnamed: R51.2, R55.2, U11.3 (+)
unnamed: R52.1, R54.1, U14.3 (VREF)
unnamed: R53.1, U14.4 (VOUT0)
unnamed: R53.2, R56.2, U11.5 (+)

Notes on the sheet:
I2C Address 0x60

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
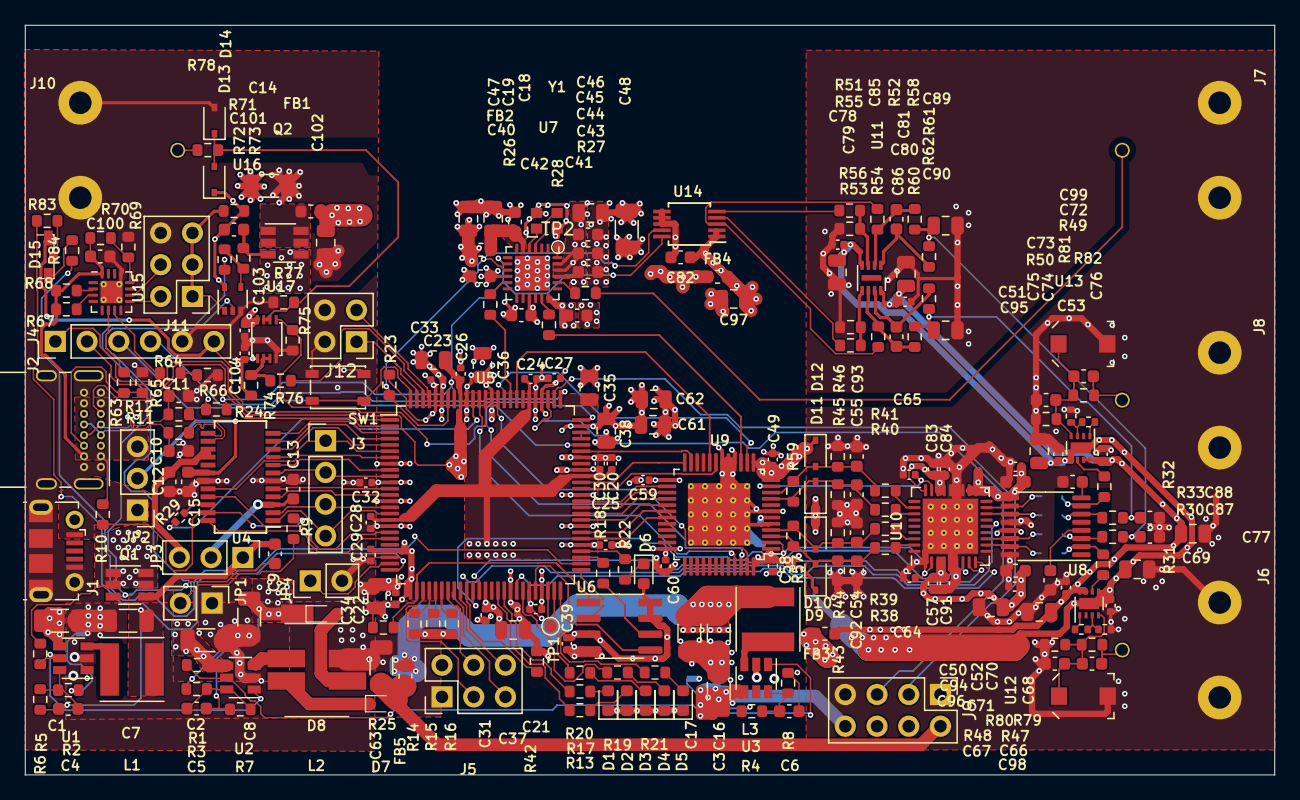
[picture p8: board ft240x_fpga_test.kicad_pcb from above]

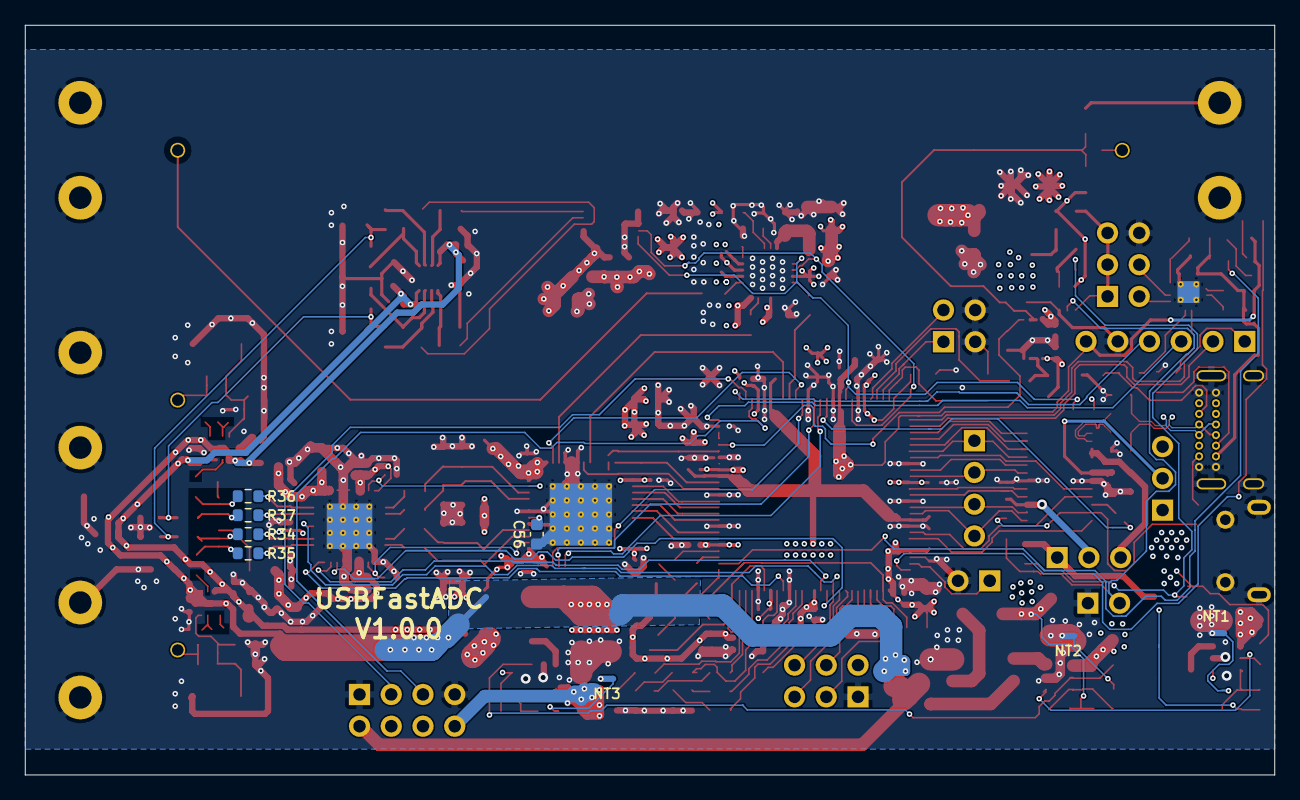
[picture p9: board ft240x_fpga_test.kicad_pcb from below]

Board: 4 copper layers, 100.0 x 60.0 mm, 253 parts (8 on the bottom side), 180 nets.

Other parts of the board:
R78: 50; R_0603_1608Metric

Their connections:
/fpga_xc3s/sheet60F7998F/DIGIO: R78.1; also elsewhere on the board
