till-s/kicad-usbadc-s7m19507/hdl/top.vhd

----------------------------------------------------------------------------------
-- Company: 
-- Engineer: 
-- 
-- Create Date:    22:12:45 08/24/2021 
-- Design Name: 
-- Module Name:    top - rtl 
-- Project Name: 
-- Target Devices: 
-- Tool versions: 
-- Description: 
--
-- Dependencies: 
--
-- Revision: 
-- Revision 0.01 - File Created
-- Additional Comments: 
--
----------------------------------------------------------------------------------
library ieee;
use ieee.std_logic_1164.all;
use ieee.numeric_std.all;

-- Uncomment the following library declaration if instantiating
-- any Xilinx primitives in this code.
library unisim;
use unisim.vcomponents.all;

use work.CommandMuxPkg.all;

entity top is
   generic (
      DEVICE_G     : string          := "xc3s200a"
   );
   port (
      IO_0         : in    std_logic;
      IO_L02_P_0   : in    std_logic;
      IO_L02_N_0   : in    std_logic;
      IP_0         : in    std_logic := 'H';

      IO_L03_P_0   : inout std_logic := 'Z';
      IO_L03_N_0   : inout std_logic := 'Z';
      IO_L04_P_0   : inout std_logic := 'Z';
      IO_L04_N_0   : inout std_logic := 'Z';

      IO_L05_P_0   : inout std_logic := 'Z';
      IO_L05_N_0   : inout std_logic := 'Z';
      IO_L06_P_0   : inout std_logic := 'Z';

      IO_L01_P_1   : inout std_logic := 'Z';
      IO_L01_N_1   : inout std_logic := 'Z';
      IO_L02_P_1   : inout std_logic := 'Z';
      IO_L02_N_1   : inout std_logic := 'Z';
      IO_L03_P_1   : inout std_logic := 'Z';
      IO_L03_N_1   : inout std_logic := 'Z';
      IO_L04_P_1   : inout std_logic := 'Z';
      IO_L04_N_1   : inout std_logic := 'Z';
      IO_L05_P_1   : inout std_logic := 'Z';
      IO_L05_N_1   : inout std_logic := 'Z';
      IO_L06_P_1   : inout std_logic := 'Z';
      IO_L06_N_1   : inout std_logic := 'Z';

      IO_L01_N_2   : inout std_logic := 'Z';
      IO_L02_N_2   : inout std_logic := 'Z';
      IO_L03_P_2   : inout std_logic := 'Z';
      IO_L04_P_2   : inout std_logic := 'Z';
      IO_L03_N_2   : inout std_logic := 'Z';
      IO_L04_N_2   : inout std_logic := 'Z';
      IO_L05_P_2   : inout std_logic := 'Z';
      IO_L06_P_2   : inout std_logic := 'Z';
      IO_L05_N_2   : inout std_logic := 'Z';
      IO_L06_N_2   : inout std_logic := 'Z';
      IO_L07_P_2   : inout std_logic := 'Z';
      IO_L07_N_2   : inout std_logic := 'Z';
      IO_L08_P_2   : inout std_logic := 'Z';
      IO_L08_N_2   : inout std_logic := 'Z';
      IO_L09_P_2   : inout std_logic := 'Z';
      IO_L09_N_2   : inout std_logic := 'Z';
      IO_2         : inout std_logic := 'Z';
      IO_L10_P_2   : inout std_logic := 'Z';
      IO_L10_N_2   : inout std_logic := 'Z';
      IO_L11_P_2   : inout std_logic := 'Z';
      IO_L11_N_2   : inout std_logic := 'Z';
      IO_L12_P_2   : inout std_logic := 'Z';
      IO_L12_N_2   : inout std_logic := 'Z';

      IO_L01_P_3   : inout std_logic := 'Z';
      IO_L01_N_3   : inout std_logic := 'Z';
      IO_L02_P_3   : inout std_logic := 'Z';
      IO_L02_N_3   : inout std_logic := 'Z';
      IP_3         : inout std_logic := 'Z';
      IO_L03_P_3   : inout std_logic := 'Z';
      IO_L03_N_3   : inout std_logic := 'Z';
      IO_L04_P_3   : inout std_logic := 'Z';
      IO_L04_N_3   : inout std_logic := 'Z';
      IO_L05_P_3   : inout std_logic := 'Z';
      IO_L05_N_3   : inout std_logic := 'Z';
      IO_L06_P_3   : inout std_logic := 'Z';
      IO_L06_N_3   : inout std_logic := 'Z'
   );
end top;

architecture rtl of top is

   constant XC3S50A_C      : string          := "xc3s50a";
   constant XC3S200A_C     : string          := "xc3s200a";

   -- keep this here as a constant so it
   -- is recorded in git.
   constant GEN_ICAP_C     : boolean         := true;

   constant GEN_ILA_C      : boolean         := false;
   constant GEN_ICAP_ILA_C : boolean         := (DEVICE_G = "xc3s50a");
   constant GEN_NO_ADCCLK_C: boolean         := false;
   constant GEN_DUMMY_C    : boolean         := false;

   constant ADC_BITS_C     : natural         := 8;

   function MB_ADDR_F   return std_logic_vector is
     variable v : std_logic_vector(7 downto 0);
   begin
      -- xc3s200a uses < 0x30000 bytes for configuration
      if ( GEN_ICAP_C ) then
         v := x"03";
      else
         v := x"00";
      end if;
      return v;
   end function MB_ADDR_F;

   function MEM_DEPTH_F return natural is
   begin
      if    ( DEVICE_G = XC3S200A_C ) then
         return (16*1024);
      else
         if ( GEN_ICAP_ILA_C ) then
            return ( 1*1024);
         else
            -- can't infer 3*1024, unfortunately; would have to hand code...
            return ( 2*1024);
         end if;
      end if;
   end function MEM_DEPTH_F;

   function DISABLE_DECIMATORS_F return boolean is
   begin
      return ( DEVICE_G /= XC3S200A_C );
   end function DISABLE_DECIMATORS_F;

   constant NUM_LED_C         : natural := 7;

   constant FIFO_CLOCK_FREQ_C : real := 24.0E6;

   type FifoVariantType is ( LOOPBACK, BITBANG );

   constant FIFO_VARIANT_C : FifoVariantType := BITBANG;
   constant BB_INIT_C      : std_logic_vector(7 downto 0) := x"F1";

   constant FEG_REG_LEN_C  : natural         := 8;
   constant FEG_REG_INIT_C : std_logic_vector(FEG_REG_LEN_C - 1 downto 0) := (
      others => '0'
   );

   signal led         : std_logic_vector(NUM_LED_C - 1 downto 0) := (others => '1');

   signal J12B        : std_logic;

   signal fifoData_i  : std_logic_vector(7 downto 0);
   signal fifoData_o  : std_logic_vector(7 downto 0) := (others => '0');
   signal fifoData_t  : std_logic_vector(7 downto 0) := (others => '1');

   signal fifoWR      : std_logic := '0';
   signal fifoRDb     : std_logic := '1';
   signal fifoTXFull  : std_logic;
   signal fifoRXEmpty : std_logic;
   signal fifoSiWu    : std_logic := '1'; -- "flush fifo to PC" when low
   signal fifoIOT     : std_logic := '1'; -- IO-buffer direction control

   signal fifoRDat    : std_logic_vector(7 downto 0);
   signal fifoRRdy    : std_logic := '1';
   signal fifoRVld    : std_logic;

   signal fifoWDat    : std_logic_vector(7 downto 0) := x"00";
   signal fifoWRdy    : std_logic;
   signal fifoWVld    : std_logic := '0';
   
   signal TP1_t       : std_logic := '1';
   signal TP1_o       : std_logic := '0';
   signal TP1_i       : std_logic;

   signal fifoClk     : std_logic;
   signal fifoRst     : std_logic := '0';

   signal pllClk      : std_logic;
   signal pllRst      : std_logic := '0';

   signal chnlAClk    : std_logic;

   signal sda_i       : std_logic;
   signal sda_t       : std_logic := '1';
   signal scl_i       : std_logic;
   signal scl_t       : std_logic := '1';

   signal spi_sck     : std_logic := '0';
   signal spi_csb     : std_logic := '1';
   signal spi_mosi    : std_logic := '0';
   signal spi_miso    : std_logic;

   signal adc_i       : std_logic_vector(ADC_BITS_C downto 0);
   signal adc_o       : std_logic_vector(ADC_BITS_C downto 0) := (others => '0');
   signal adc_t       : std_logic_vector(ADC_BITS_C downto 0) := (others => '1');
   signal adcDClk     : std_logic;
   signal adcSync     : std_logic := '0';
   signal adcDRst     : std_logic := '0';
   signal adcSClk     : std_logic := '0';
   signal adcSD_i     : std_logic := '0';
   signal adcSD_o     : std_logic := '0';
   signal adcSD_t     : std_logic := '1';
   signal adcSCSb     : std_logic := '1';
   signal adcDcmLckd  : std_logic := '0';

   signal fegSCSb     : std_logic := '1';
   signal fegSDI      : std_logic;
   signal fegSDO      : std_logic;
   signal fegReg      : std_logic_vector(FEG_REG_LEN_C - 1 downto 0) := FEG_REG_INIT_C;
   signal fegSRDat    : std_logic_vector(FEG_REG_LEN_C - 1 downto 0);
   signal fegWen      : std_logic;
   signal fegRen      : std_logic;
   signal fegA        : std_logic_vector(1 downto 0);


   signal pgaSClk     : std_logic := '0';
   signal pgaSDI      : std_logic := '0';
   signal pgaSDO      : std_logic := '0';
   signal pgaSCSb     : std_logic := '1';


   signal bbi         : std_logic_vector( 7 downto 0) := (others => '0');
   signal bbo         : std_logic_vector( 7 downto 0) := BB_INIT_C;

   -- when ioDir is low then ioDat is an input otherwise an output
   signal ioDir_i     : std_logic;
   signal ioDir_o     : std_logic := '0';
   signal ioDir_t     : std_logic := '1';

   signal ioDat_i     : std_logic;
   signal ioDat_o     : std_logic := '0';
   signal ioDat_t     : std_logic := '1';

   signal cnt         : unsigned(23 downto 0) := (others => '0');
   signal pllCnt      : unsigned(25 downto 0) := (others => '0');
   signal dumCnt      : unsigned(25 downto 0) := (others => '0');

   signal multiBoot   : std_logic := '0';

   component ila_1br is
      PORT (
         CONTROL : INOUT STD_LOGIC_VECTOR(35 DOWNTO 0);
         CLK     : IN STD_LOGIC;
         TRIG0   : IN STD_LOGIC_VECTOR(7 DOWNTO 0);
         TRIG1   : IN STD_LOGIC_VECTOR(7 DOWNTO 0);
         TRIG2   : IN STD_LOGIC_VECTOR(7 DOWNTO 0);
         TRIG3   : IN STD_LOGIC_VECTOR(7 DOWNTO 0)
      );
   end component ila_1br;

   component chipscope_icon is
      PORT (
         control0 : out std_logic_vector(35 downto 0)
      );
   end component chipscope_icon;

   signal ila_trg0 : std_logic_vector( 7 downto 0) := (others => '0');
   signal ila_trg1 : std_logic_vector( 7 downto 0) := (others => '0');
   signal ila_trg2 : std_logic_vector( 7 downto 0) := (others => '0');
   signal ila_trg3 : std_logic_vector( 7 downto 0) := (others => '0');

begin

   assert ( DEVICE_G = XC3S50A_C or DEVICE_G = XC3S200A_C ) report "Unsupported device" severity failure;

   U_FIFOCLK_BUF : component IBUFG
      port map (
         I => IO_0,
         O => fifoClk
      );
 
   U_PLLCLK_BUF : component IBUFG
      port map (
         I => IO_L02_N_0,
         O => pllClk
      );
 
   GEN_ADCCLK : if ( not GEN_NO_ADCCLK_C ) generate
      U_ADCCLK_BUF : component IBUFG
         port map (
            I => IO_L02_P_0,
            O => adcDClk
         );
   end generate GEN_ADCCLK;

   GEN_NO_ADCCLK : if ( GEN_NO_ADCCLK_C ) generate
      adcDClk <= pllClk;
      adcDRst <= pllRst;
   end generate GEN_NO_ADCCLK;


   -- FIFO
   U_FIFO_BUF : entity work.IOBufArray
      generic map (
         WIDTH_G => 8
      )
      port map (
         i     => fifoData_i,
         o     => fifoData_o,
         t     => fifoData_t,
         io(0) => IO_L06_N_3,
         io(1) => IO_L04_N_3,
         io(2) => IO_L05_P_3,
         io(3) => IO_L02_N_3,
         io(4) => IO_L05_N_3,
         io(5) => IO_L03_N_3,
         io(6) => IO_L03_P_3,
         io(7) => IO_L04_P_3
      );

   IO_L01_P_3  <= fifoWR;
   IO_L01_N_3  <= fifoRDb;
   IO_L02_P_3  <= fifoSiWu;
   fifoTXFull  <= IP_3;
   fifoRXEmpty <= IO_L06_P_3;

   IO_L12_P_2 <= led(6); -- front LED, green
   IO_L01_N_2 <= led(5); -- front LED, red
   IO_L08_N_2 <= led(4);
   IO_L08_P_2 <= led(3);
   IO_L10_N_2 <= led(2);
   IO_L09_N_2 <= led(1);
   IO_L11_P_2 <= led(0);

   IO_L10_P_2 <= 'Z' when TP1_t = '1' else TP1_o;
   TP1_i      <= IO_L10_P_2;

   IO_L05_P_0 <= 'Z' when sda_t = '1' else '0';
   sda_i      <= IO_L05_P_0;
   IO_L05_N_0 <= 'Z' when scl_t = '1' else '0';
   scl_i      <= IO_L05_N_0;

   IO_L05_N_1 <= 'Z' when ioDir_t = '1' else ioDir_o;
   ioDir_i    <= IO_L05_N_1;

   IO_L06_P_0 <= 'Z' when ioDat_t = '1' else ioDat_o;
   ioDat_i    <= IO_L06_P_0;

   ioDir_t    <= '0';
   ioDat_t    <= not ioDir_o;

   P_REG : process ( fifoClk ) is
   begin
      if ( rising_edge( fifoClk ) ) then
         cnt <= cnt + 1;
      end if;
   end process P_REG;

   P_REGA : process ( adcDClk ) is
   begin
      if ( rising_edge( adcDClk ) ) then
         pllCnt <= pllCnt + 1;
      end if;
   end process P_REGA;

   P_REGB : process ( chnlAClk ) is
   begin
      if ( rising_edge( chnlAClk ) ) then
         dumCnt <= dumCnt + 1;
      end if;
   end process P_REGB;
  
   led(6)          <= not led(1);
   led(5)          <= not cnt(cnt'left) when GEN_ICAP_C else '0';
   led(4)          <= '1'               when GEN_ICAP_C else '0';
   led(3)          <= adcDcmLckd;
   led(2)          <= dumCnt(dumCnt'left);
   led(1)          <= pllCnt(pllCnt'left);
   led(0)          <= cnt(cnt'left);

   -- ADC
   IO_L03_P_0      <= adcSync;

   adc_i(ADC_BITS_C - 0) <= IO_L01_P_1;
   adc_i(ADC_BITS_C - 1) <= IO_L01_N_1;
   adc_i(ADC_BITS_C - 2) <= IO_L02_P_1;
   adc_i(ADC_BITS_C - 3) <= IO_L02_N_1;
   adc_i(ADC_BITS_C - 4) <= IO_L03_P_1;
   adc_i(ADC_BITS_C - 5) <= IO_L03_N_1;
   adc_i(ADC_BITS_C - 6) <= IO_L04_N_1;
   adc_i(ADC_BITS_C - 7) <= IO_L05_P_1;

   adc_i(0)              <= IO_L04_P_1; -- DOR bit

   GEN_DUMMY : if ( GEN_DUMMY_C ) generate
      -- adc_t is abused as an intermediate signal here
      -- IDDR/ODDR cannot use three-state buffers, apparently

      IO_L04_P_1 <= adc_o(0); -- DOR bit
      IO_L05_P_1 <= adc_o(1);
      IO_L04_N_1 <= adc_o(2);
      IO_L03_N_1 <= adc_o(3);
      IO_L03_P_1 <= adc_o(4);
      IO_L02_N_1 <= adc_o(5);
      IO_L02_P_1 <= adc_o(6);
      IO_L01_N_1 <= adc_o(7);
      IO_L01_P_1 <= adc_o(8);

      GEN_ODDR : for i in adc_o'range generate
         U_OBUF : component OBUF
            port map (
               I   => adc_t(i),
               O   => adc_o(i)
            );
         U_ODDR : component ODDR2
            port map (
               Q   => adc_t(i),
               C0  => not chnlAClk,
               C1  => chnlAClk,
               D0  => pllCnt(i),
               D1  => dumCnt(i+1),
               R   => '0',
               S   => '0'
            );
      end generate GEN_ODDR;
   end generate GEN_DUMMY;

   GEN_NO_DUMMY : if ( not GEN_DUMMY_C ) generate
      IO_L04_P_1 <= 'Z'; -- DOR bit
      IO_L05_P_1 <= 'Z';
      IO_L04_N_1 <= 'Z';
      IO_L03_N_1 <= 'Z';
      IO_L03_P_1 <= 'Z';
      IO_L02_N_1 <= 'Z';
      IO_L02_P_1 <= 'Z';
      IO_L01_N_1 <= 'Z';
      IO_L01_P_1 <= 'Z';
   end generate GEN_NO_DUMMY;


   IO_L03_N_0      <= adcSCSb;
   IO_L04_P_0      <= adcSClk;
   IO_L04_N_0      <= 'Z' when adcSD_t = '1' else adcSD_o;
   adcSD_i         <= IO_L04_N_0;

   -- PGA
   IO_L09_P_2      <= pgaSCSb;
   IO_L07_N_2      <= pgaSClk;
   IO_L07_P_2      <= pgaSDO;
   pgaSDI          <= IO_L06_N_2;

   J12B            <= IP_0;

   U_FIFO_IF : entity work.Ft240Fifo
      generic map (
         CLOCK_FREQ_G => FIFO_CLOCK_FREQ_C
      )
      port map (
         clk     => fifoClk,
         rst     => fifoRst,

         fifoRXE => fifoRXEmpty,
         fifoRDT => fifoData_i,
         fifoRDb => fifoRDb,

         fifoTXF => fifoTXFull,
         fifoWDT => fifoData_o,
         fifoWR  => fifoWR,

         fifoIOT => fifoIOT,

         rdat    => fifoRDat,
         rvld    => fifoRVld,
         rrdy    => fifoRRdy,

         wdat    => fifoWDat,
         wvld    => fifoWVld,
         wrdy    => fifoWRdy
      );

   ila_trg0(0) <= fifoRXEmpty;
   ila_trg0(1) <= fifoRDb;
   ila_trg0(2) <= fifoRVld;
   ila_trg0(3) <= fifoRRdy;

   ila_trg0(4) <= fifoTXFull;
   ila_trg0(5) <= fifoWR;
   ila_trg0(6) <= fifoWVld;
   ila_trg0(7) <= fifoWRdy;

   ila_trg1    <= fifoRDat;
   ila_trg2    <= fifoWDat;

   GEN_ILA : if ( GEN_ILA_C ) generate

      U_ILA : entity work.ILAWrapper
         port map(
            clk   => fifoClk,
            trg0  => ila_trg0,
            trg1  => ila_trg1,
            trg2  => ila_trg2,
            trg3  => ila_trg3
         );

   end generate GEN_ILA;

   fifoData_t <= (others => fifoIOT);

   IO_L02_N_2 <= spi_csb;
   IO_L12_N_2 <= spi_sck;
   IO_2       <= spi_mosi;
   IO_L11_N_2 <= 'Z'; -- spi MISO
   spi_miso   <= IO_L11_N_2;

   GEN_LOOPBACK : if ( FIFO_VARIANT_C = LOOPBACK ) generate

      -- FIFO Loopback
      fifoWDat   <= fifoRDat;
      fifoRRdy   <= fifoWRdy;
      fifoWVld   <= fifoRVld;

   end generate GEN_LOOPBACK;

   -- Bit-bang!
   GEN_BITBANG : if ( FIFO_VARIANT_C = BITBANG ) generate

      constant BB_SPI_CSb_C  : natural := 0;
      constant BB_SPI_SCK_C  : natural := 1;
      constant BB_SPI_MSO_C  : natural := 2;
      constant BB_SPI_MSI_C  : natural := 3;

      constant BB_I2C_SDA_C  : natural := 4;
      constant BB_I2C_SCL_C  : natural := 5;

      constant BB_SPI_T_C    : natural := 6;
      constant BB_XXX_XXX_C  : natural := 7;

      signal   subCmdBB      : SubCommandBBType;

      signal   spiIla0       : std_logic_vector(7 downto 0) := (others => '0');
      signal   spiIla1       : std_logic_vector(7 downto 0) := (others => '0');
      signal   spiIla2       : std_logic_vector(7 downto 0) := (others => '0');
      signal   spiIla3       : std_logic_vector(7 downto 0) := (others => '0');

   begin

      spiIla0(2 downto 0) <= subCmdBB; 
      spiIla0(3         ) <= '0';
      spiIla0(4         ) <= pgaSCSb;
      spiIla0(5         ) <= pgaSClk;
      spiIla0(6         ) <= pgaSDO;
      spiIla0(7         ) <= pgaSDI;

      spiIla1(2 downto 0) <= (others => '0');
      spiIla1(3         ) <= adcSD_t;
      spiIla1(4         ) <= adcSCSb;
      spiIla1(5         ) <= adcSClk;
      spiIla1(6         ) <= adcSD_o;
      spiIla1(7         ) <= adcSD_i;

      spiIla2(         0) <= spi_sck;
      spiIla2(         1) <= spi_mosi;
      spiIla2(         2) <= spi_miso;
      spiIla2(         3) <= spi_csb;
      spiIla2(7 downto 4) <= (others => '0');

      GEN_ILA : if ( false ) generate
      U_ILA : entity work.ILAWrapper
         port map(
            clk   => fifoClk,
            trg0  => spiIla0,
            trg1  => spiIla1,
            trg2  => spiIla2,
            trg3  => spiIla3
         );
      end generate GEN_ILA;
 
      spi_sck           <= bbo(BB_SPI_SCK_C);
      spi_mosi          <= bbo(BB_SPI_MSO_C);

      adcSClk           <= bbo(BB_SPI_SCK_C);
      adcSD_o           <= bbo(BB_SPI_MSO_C);

      pgaSClk           <= bbo(BB_SPI_SCK_C);
      pgaSDO            <= bbo(BB_SPI_MSO_C);

      sda_t             <= bbo(BB_I2C_SDA_C);
      scl_t             <= bbo(BB_I2C_SCL_C);

      bbi(BB_I2C_SDA_C) <= sda_i;
      bbi(BB_I2C_SCL_C) <= scl_i;

      bbi(BB_SPI_SCK_C) <= bbo(BB_SPI_SCK_C);
      bbi(BB_SPI_CSb_C) <= bbo(BB_SPI_CSb_C);
      bbi(BB_SPI_MSO_C) <= bbo(BB_SPI_MSO_C);

      bbi(BB_SPI_T_C  ) <= '0';
      bbi(BB_XXX_XXX_C) <= bbi(BB_XXX_XXX_C);

      P_SPI_CS_MUX : process ( subCmdBB, bbo, spi_miso, adcSD_i, pgaSDI ) is
      begin
         spi_csb <= '1';
         adcSCSb <= '1';
         pgaSCSb <= '1';
         fegSCSb <= '1';
         adcSD_t <= '1';
         fegSDI  <= fegSDO; -- loopback for pure read operation

         if    ( subCmdBB = CMD_BB_SPI_ROM_C ) then
               spi_csb           <= bbo(BB_SPI_CSb_C);
               bbi(BB_SPI_MSI_C) <= spi_miso;
         elsif ( subCmdBB = CMD_BB_SPI_ADC_C ) then
               adcSCSb           <= bbo(BB_SPI_CSb_C);
               adcSD_t           <= bbo(BB_SPI_T_C  );
               bbi(BB_SPI_MSI_C) <= adcSD_i;
         elsif ( subCmdBB = CMD_BB_SPI_PGA_C ) then
               pgaSCSb           <= bbo(BB_SPI_CSb_C);
               bbi(BB_SPI_MSI_C) <= pgaSDI;
         elsif ( subCmdBB = CMD_BB_SPI_FEG_C ) then
               fegSCSb           <= bbo(BB_SPI_CSb_C);
               bbi(BB_SPI_MSI_C) <= fegSDO;
               -- use the 'hiz' bit as a read/writeb indicator
               if ( bbo(BB_SPI_T_C) = '0' ) then
                  fegSDI <= spi_mosi;
               end if;
         else
               bbi(BB_SPI_MSI_C) <= '0';
         end if;
      end process P_SPI_CS_MUX;

      GEN_ADC_ILA : if ( false ) generate
         signal adcTrg0 : std_logic_vector(7 downto 0) := (others => '0');
         signal adcTrg1 : std_logic_vector(7 downto 0) := (others => '0');
         signal adcTrg2 : std_logic_vector(7 downto 0) := (others => '0');
         signal adcTrg3 : std_logic_vector(7 downto 0) := (others => '0');
      begin
         adcTrg0 <= adc_i(8 downto 1);
         adcTrg1 <= ( 0 => adc_i(0), others => '0');
         U_ADC_ILA : entity work.ILAWrapper
            port map (
               clk  => adcDClk,
               trg0 => adcTrg0,
               trg1 => adcTrg1,
               trg2 => adcTrg2,
               trg3 => adcTrg3
            );
      end generate GEN_ADC_ILA;

      U_COMMAND_WRAPPER : entity work.CommandWrapper
         generic map (
            I2C_SCL_G            => BB_I2C_SCL_C,
            BBO_INIT_G           => BB_INIT_C,
            MEM_DEPTH_G          => MEM_DEPTH_F,
            ADC_BITS_G           => ADC_BITS_C,
            FIFO_FREQ_G          => FIFO_CLOCK_FREQ_C,
            DISABLE_DECIMATORS_G => DISABLE_DECIMATORS_F
         )
         port map (
            clk                  => fifoClk, 
            rst                  => fifoRst, 
            
            datIb                => fifoRDat,
            vldIb                => fifoRVld,
            rdyIb                => fifoRRdy,

            datOb                => fifoWDat,
            vldOb                => fifoWVld,
            rdyOb                => fifoWRdy,

            bbo                  => bbo,
            bbi                  => bbi,
            subCmdBB             => subCmdBB,

            adcClk               => adcDClk,
            adcRst               => adcDRst,

            adcDataDDR           => adc_i,
            smplClk              => chnlAClk,
            adcDcmLocked         => adcDcmLckd
         );

      P_FEG_REG : process ( fifoClk ) is
      begin
         if ( rising_edge( fifoClk ) ) then
            if ( fifoRst = '1' ) then
               fegReg <= FEG_REG_INIT_C;
            elsif ( fegWen = '1' ) then
               fegReg <= fegSRDat;
            end if;
         end if;
      end process P_FEG_REG;

      fegA <= fegReg(1 downto 0) when fegReg(1 downto 0) /= "00" else "11";

      IO_L05_P_2 <= fegA(1);
      IO_L05_N_2 <= fegA(0);

      U_FEG_SPI : entity work.SpiReg
         generic map (
            NUM_BITS_G => FEG_REG_LEN_C,
            INIT_VAL_G => FEG_REG_INIT_C
         )
         port map (
            clk        => fifoClk,
            rst        => fifoRst,

            sclk       => spi_sck,
            scsb       => fegSCSb,
            mosi       => fegSDI,
            miso       => fegSDO,

            data_inp   => fegReg,
            rs         => fegRen,
            data_out   => fegSRDat,
            ws         => fegWen
         );
   end generate GEN_BITBANG;


   GEN_ICAP : if ( GEN_ICAP_C ) generate

      subtype  IcapSlv      is std_logic_vector(7 downto 0);

      type IcapPrgItemType  is record
         data                : IcapSlv;
         RWb                 : std_logic;
      end record IcapPrgItemType;

      type     IcapPrgArray is array (natural range <>) of IcapPrgItemType;

	  constant ICAP_WAIT_C   : integer := 4;

      -- reading back GENERAL2 does not work when an image is loaded from jtag
      -- we always read back 0b00 (spi cmd + 0x00 address byte).
      -- It does seem to work when configuring from flash -- but it is no use
      -- to try to determine if this was a multiboot because the bitstream
      -- writes GENERAL1/2 every time (even if we tell bitgen not to embed the
      -- next address -- it will then simply be 0x00000000).
      -- UPDATE: this solution works -- we just need to pass bitgen the
      --            -g next_config_register_write:Disable
      --         option :-)
      constant ICAP_PROG_MB_C: IcapPrgArray (26 downto 1) := (
         -- UG332
         (RWb => '0', data => x"FF"), -- Dummy      (hi)
         (RWb => '0', data => x"FF"), --            (lo)
         (RWb => '0', data => x"AA"), -- SYNC       (hi)
         (RWb => '0', data => x"99"), --            (lo)
         (RWb => '0', data => "00101010"), -- Read GENERAL2 (hi)
         (RWb => '0', data => "10000001"), --        (lo)
         (RWb => '0', data => x"20"), -- NOOP       (hi) -- flush 'pipeline' with 2 no-ops
         (RWb => '0', data => x"00"), --            (lo)
         (RWb => '0', data => x"20"), -- NOOP       (hi)
         (RWb => '0', data => x"00"), --            (lo)
         (RWb => '1', data => x"FF"), --            (xx) -- readout after 3 clocks
         (RWb => '1', data => x"FF"), --            (xx)
         (RWb => '1', data => x"FF"), --            (hi)
         (RWb => '1', data => x"FF"), --            (lo)
         (RWb => '0', data => "00110010"), -- Write GENERAL1 (hi)
         (RWb => '0', data => "01100001"), --        (lo)
         (RWb => '0', data => x"00"), --  A16..A8   (hi)
         (RWb => '0', data => x"00"), --  A07..A0   (lo)
         (RWb => '0', data => "00110010"), -- Write GENERAL2 (hi)
         (RWb => '0', data => "10000001"), --        (lo)
         (RWb => '0', data => x"00"), --  SPI CMD   (hi) (0x00 seems to indicate 'last command')
         (RWb => '0', data => MB_ADDR_F ), --  A23..16   (lo)
--       (RWb => '0', data => x"30"), -- CMD        (hi)
--       (RWb => '0', data => x"A1"), --            (lo)
--       (RWb => '0', data => x"00"), -- REBOOT     (hi)
--       (RWb => '0', data => x"0E"), --            (lo)
         (RWb => '0', data => x"20"), -- NOOP       (hi)
         (RWb => '0', data => x"00"), --            (lo)
         (RWb => '0', data => x"20"), -- NOOP       (hi)
         (RWb => '0', data => x"00")  --            (lo)
      );

      constant ICAP_PROG_RD_C: IcapPrgArray (18 downto 1) := (
         -- UG332
         (RWb => '0', data => x"FF"), -- Dummy      (hi)
         (RWb => '0', data => x"FF"), --            (lo)
         (RWb => '0', data => x"AA"), -- SYNC       (hi)
         (RWb => '0', data => x"99"), --            (lo)
         (RWb => '0', data => "00101010"), -- Read GENERAL2 (hi)
         (RWb => '0', data => "10000001"), --        (lo)
         (RWb => '0', data => x"20"), -- NOOP       (hi)
         (RWb => '0', data => x"00"), --            (lo)
         (RWb => '0', data => x"20"), -- NOOP       (hi)
         (RWb => '0', data => x"00"), --            (lo)
         (RWb => '1', data => x"FF"), --            (hi)
         (RWb => '1', data => x"FF"), --            (lo)
         (RWb => '1', data => x"FF"), --            (lo)
         (RWb => '1', data => x"FF"), --            (lo)
         (RWb => '0', data => x"20"), -- NOOP       (hi)
         (RWb => '0', data => x"00"), --            (lo)
         (RWb => '0', data => x"20"), -- NOOP       (hi)
         (RWb => '0', data => x"00") --            (lo)
      );

      constant ICAP_PROG_C     : IcapPrgArray := ICAP_PROG_MB_C;

      constant ICAP_IDX_INIT_C : integer := ICAP_WAIT_C + ICAP_PROG_C'left;

      subtype  IcapIdxType  is integer range ICAP_IDX_INIT_C downto 0;

      type   IcapRegType    is record
         idx                 : IcapIdxType;
         RWb                 : std_logic;
         jmp                 : std_logic;
      end record IcapRegType;

      constant ICAP_REG_INIT_C : IcapRegType                := (
         idx                 => ICAP_IDX_INIT_C,
         RWb                 => '0',
         jmp                 => '0'
      );

      signal icapCEb         : std_ulogic                   := '0';
      signal icapDin         : std_logic_vector(7 downto 0) := (others => '1');
      signal icapDou         : std_logic_vector(7 downto 0);
      signal icapRWb         : std_ulogic                   := '0';
      signal icapBSY         : std_ulogic;

      signal icapReg         : IcapRegType := ICAP_REG_INIT_C;
      signal icapRin         : IcapRegType;

      signal icapIla0        : std_logic_vector(7 downto 0);
      signal icapIla1        : std_logic_vector(7 downto 0);
      signal icapIla2        : std_logic_vector(7 downto 0);
      signal icapIla3        : std_logic_vector(7 downto 0);

      signal J12BLoc         : std_logic := '0';

   begin

      icapRWb <= icapReg.RWb;
      J12BLoc <= icapReg.jmp;

      P_ICAP_COMB : process( icapReg, J12B ) is
         variable v : IcapRegType;
      begin
         v       := icapReg;
         icapDin <= x"FF";
         icapCEb <= '1';
         if ( icapReg.idx > 0 ) then
            v.idx   := icapReg.idx - 1;
         end if;
         if ( icapReg.idx >= ICAP_PROG_C'low  and icapReg.idx <= ICAP_PROG_C'high ) then
            if ( (multiBoot or not J12B) = '1' ) then
               v.jmp := '1';
            end if;
            if ( v.jmp = '1' ) then
               icapDin <= ICAP_PROG_C(icapReg.idx).data(7 downto 0);
               icapCEb <= '0';
               if ( icapReg.RWb /= ICAP_PROG_C(icapReg.idx).RWb ) then
                  icapCEb <= '1';
                  v.idx := icapReg.idx;
                  v.RWb := not v.RWb;
               end if;
            else
               v.idx := icapReg.idx;
            end if;
         end if;
         icapRin <= v;
      end process P_ICAP_COMB;

      P_ICAP : process ( fifoClk ) is
      begin
         if ( rising_edge( fifoClk ) ) then
            if ( fifoRst = '1' ) then
               icapReg <= ICAP_REG_INIT_C;
            else
               icapReg <= icapRin;
            end if;
         end if;
      end process P_ICAP;

      icapIla0 <= icapDin;
      icapIla1 <= icapDou;
      icapIla2 <= ( 0 => icapCEb, 1 => icapRWb, 2 => J12B, 3 => J12BLoc, 4 => '1', 7 => icapBSY, others => '0' );
      icapIla3 <= std_logic_vector( to_unsigned( icapReg.idx, 8 ) );

      GEN_ICAP_ILA : if ( GEN_ICAP_ILA_C ) generate

         U_ICAP_ILA : entity work.ILAWrapper
            port map(
               clk   => fifoClk,
               trg0  => icapIla0,
               trg1  => icapIla1,
               trg2  => icapIla2,
               trg3  => icapIla3
            );

      end generate GEN_ICAP_ILA;

      U_ICAP : component ICAP_SPARTAN3A
         port map (
            BUSY  => icapBSY,    -- : out std_ulogic;
            CE    => icapCEb,    -- : in  std_ulogic;
            CLK   => fifoClk,    -- : in  std_ulogic;
            I(0)  => icapDin(7), -- : in  std_logic_vector(7 downto 0);
            I(1)  => icapDin(6), -- : in  std_logic_vector(7 downto 0);
            I(2)  => icapDin(5), -- : in  std_logic_vector(7 downto 0);
            I(3)  => icapDin(4), -- : in  std_logic_vector(7 downto 0);
            I(4)  => icapDin(3), -- : in  std_logic_vector(7 downto 0);
            I(5)  => icapDin(2), -- : in  std_logic_vector(7 downto 0);
            I(6)  => icapDin(1), -- : in  std_logic_vector(7 downto 0);
            I(7)  => icapDin(0), -- : in  std_logic_vector(7 downto 0);
            O(0)  => icapDou(7), -- : in  std_logic_vector(7 downto 0);
            O(1)  => icapDou(6), -- : in  std_logic_vector(7 downto 0);
            O(2)  => icapDou(5), -- : in  std_logic_vector(7 downto 0);
            O(3)  => icapDou(4), -- : in  std_logic_vector(7 downto 0);
            O(4)  => icapDou(3), -- : in  std_logic_vector(7 downto 0);
            O(5)  => icapDou(2), -- : in  std_logic_vector(7 downto 0);
            O(6)  => icapDou(1), -- : in  std_logic_vector(7 downto 0);
            O(7)  => icapDou(0), -- : in  std_logic_vector(7 downto 0);
            WRITE => icapRWb     -- : in  std_ulogic
         );
   end generate GEN_ICAP;

end rtl;
