till-s/kicad-usbadc-s7m19507/(commit log)

2021-05-13 git import
    [ft240x_fpga_test.kicad_pcb, ft240x_fpga_test.sch]
2021-05-13 added missing schematic files
    [fpga_xc3s.sch, pll_clock.sch, power.sch]
2021-05-13 .gitignore: ignore .xml file; seems to be generated by BOM
2021-06-04 several updates...
    [fpga_xc3s.sch, ft240x_fpga_test.kicad_pcb, ft240x_fpga_test.sch, max19507.sch, pll_clock.sch]
2021-06-04 Started to work on analog front-end; ADC connected to fpga
    [buffer.sch, fpga_xc3s.sch, ft240x_fpga_test.kicad_pcb, ft240x_fpga_test.sch, max19507.sch, pll_clock.sch, power.sch]
2021-06-08 added buffer amps for offset dac
    [buffer.sch, fpga_xc3s.sch, ft240x_fpga_test.sch, max19507.sch, offset_dac.sch, pll_clock.sch, power.sch]
2021-07-01 more work (don't recall details :-()
    [buffer.sch, fpga_xc3s.sch, ft240x_fpga_test.kicad_pcb, max19507.sch, offset_dac.sch, pll_clock.sch, power.sch]
2021-07-19 everything hooked up + layed out; 0.2/0.4mm vias :-(
    [buffer.sch, digio.sch, fpga_xc3s.sch, ft240x_fpga_test.kicad_pcb, ft240x_fpga_test.sch, max19507.sch, offset_dac.sch, pll_clock.sch]
2021-07-19 pcb: increased min. via dia to 0.45mm (jlcpcb)
    [ft240x_fpga_test.kicad_pcb]
2021-07-20 prototype version
    [buffer.sch, digio.sch, fpga_xc3s.sch, ft240x_fpga_test.kicad_pcb, ft240x_fpga_test.sch, max19507.sch, pll_clock.sch, power.sch]
2021-07-20 changed options for gerber (according to jlcpcb instructions)
    [ft240x_fpga_test.kicad_pcb]
2021-07-20 updated gerber options according to jlcpcb instructions
    [ft240x_fpga_test.kicad_pcb]
2021-08-30 top: hooked up FIFO block -- LEDs do not work anymore ?!
    [top.vhd]
2021-09-01 BUGFIX: bit-bang interface
    would keep receiving from the fifo even if the TX fifo
    was full; losing transactions.
    Moved the bit-bang IF to a dedicated VHD module.
    [top.ucf, top.vhd]
2021-09-12 top.vhd/ucf: connected IO connector, new CommandWrapper; timing constraints
    added period constraint for adc clock. For now the pll clock is used to
    clock the block ram writing (testing).
2021-10-25 updated bit-bang interface; added CSb mux for ADC and PGA SPIs
2021-10-25 top.vhd: converted 'case' to 'if' (silence ise warnings about non locally constant items)
2021-10-28 Debugged ADC interface; seems to work now
2021-10-29 connected front LED
2021-11-14 top.vhd: connected some more SPI signals to SPI ILA
2021-11-14 removed dedicated SPI controller again (no improvement of programming speed)
2021-11-14 Reverted dedicated SPI - some fixed
    - removed SPI controller from TCL
    - had used the wrong submodule branch (still including the SPI)
2021-11-14 Removed more left-overs from dedicated-SPI test
2021-12-10 increased memory size to max supported by 200 device
2021-12-10 top.vhd: use DEVICE_G generic to disable features when built for xc3s50a
2021-12-10 top.vhd: fixed typos; added .gitignore (GitVersionPkg.vhd)
    [top.vhd]
2021-12-10 submodule update: DPRAM readout fix; switched back to dual mem anyways
2021-12-23 submodule update; fixed auto-timer (wouldn't work with decimation)
2022-01-30 top.vhd: disable ICAP_ILA (target is the xc3s200 with decimator filters)
2022-02-07 Connected a (internal) SPI register to control the front-end gain
2022-02-08 top.vhd: hooked up FEG control bits (BROKEN?); disabled ICAP
    Something seems broken; image doesn't boot :-(
    [top.vhd]
2022-02-08 top.vhd: check DEVICE_G against supported device names
2022-03-26 top.vhd: fixed IO_DAT hookup; was on IO_L06_P_1 instead of IO_L06_P_0
    [top.vhd]
2022-03-26 top.vhd: use constant to define ADC bit width
